Saqoosha/EPDEnvClock/docs/README.md

# EPDEnvClock Documentation

This directory contains various documentation for the EPDEnvClock project.

## 📚 Document List

### Feature Guides

- **[ImageBW Wi-Fi Export](./README_IMAGEBW.md)** - How to use the feature that sends ImageBW data to Mac via Wi-Fi
- **[SCD41 Sensor Integration](./README_SCD41.md)** - Connection and configuration guide for the SCD41 CO2/temperature/humidity sensor

### Analysis Reports

- **[Battery Discharge Report](./BATTERY_REPORT.md)** - 10-day battery discharge analysis with MAX17048 accuracy evaluation

### Code Reviews

- **[Sensor Management Code Review](./reviews/SENSOR_MANAGEMENT_REVIEW.md)** - Implementation status and improvement suggestions for SCD41 sensor management

## 📖 Project-Wide Documentation

The following documents are also available in the project root:

- **[AGENTS.md](../AGENTS.md)** - Arduino CLI compile/upload instructions
- **[README.md](../README.md)** - Project overview

## 🔍 Finding Documentation

- **Want to know how to use a feature** → Refer to Feature Guides
- **Want to check code issues** → Refer to Code Reviews
- **Want to know how to build/upload** → Refer to [AGENTS.md](../AGENTS.md)
