Saqoosha/EPDEnvClock/docs/README_ja.md

# EPDEnvClock ドキュメント

このディレクトリには、EPDEnvClockプロジェクトの各種ドキュメントが含まれています。

## 📚 ドキュメント一覧

### 機能ガイド

- **[ImageBW Wi-Fi Export](./README_IMAGEBW_ja.md)** - ImageBWデータをWi-Fi経由でMacに送信する機能の使い方
- **[SCD41 センサー統合](./README_SCD41_ja.md)** - SCD41 CO2/温度/湿度センサーの接続と設定ガイド

### 分析レポート

- **[バッテリー放電レポート](./BATTERY_REPORT.md)** - 10日間のバッテリー放電分析とMAX17048精度評価

### コードレビュー

- **[センサー管理コードレビュー](./reviews/SENSOR_MANAGEMENT_REVIEW_ja.md)** - SCD41センサー管理の実装状況と改善提案

## 📖 プロジェクト全体のドキュメント

プロジェクトルートには以下のドキュメントもあります：

- **[AGENTS.md](../AGENTS.md)** - Arduino CLIコンパイル・アップロード手順書
- **[README.md](../README.md)** - プロジェクト全体の概要

## 🔍 ドキュメントの探し方

- **機能の使い方を知りたい** → 機能ガイドを参照
- **コードの問題点を確認したい** → コードレビューを参照
- **ビルド・アップロード方法を知りたい** → [AGENTS.md](../AGENTS.md)を参照
