Saqoosha/EPDEnvClock/docs/README_SCD41_ja.md

# SCD41センサー統合ガイド

このドキュメントは、SCD41 CO2/温度/湿度センサーをCrowPanel ESP32-S3に接続する方法を説明します。

## ハードウェア接続

### 接続ピン

- **SCD41 VDD** → ESP32-S3 **3.3V**
- **SCD41 GND** → ESP32-S3 **GND**
- **SCD41 SDA** → ESP32-S3 **GPIO 38**
- **SCD41 SCL** → ESP32-S3 **GPIO 20**

**注意**: プルアップ抵抗はSCD41モジュールに内蔵されているため、追加のハードウェアは不要です。

## ライブラリのインストール

### Sensirion SCD4x Arduinoライブラリ

SCD41センサーを使用するには、Sensirion SCD4x Arduinoライブラリが必要です。

#### arduino-cliを使用する場合

```bash
arduino-cli lib install "Sensirion I2C SCD4x"
```

または、ライブラリのGitHubリポジトリから直接インストール：

```bash
arduino-cli lib install --git-url https://github.com/Sensirion/arduino-i2c-scd4x.git
```

#### Arduino IDEを使用する場合

1. Arduino IDEを開く
2. **スケッチ** → **ライブラリをインクルード** → **ライブラリを管理...**
3. 検索バーに「Sensirion I2C SCD4x」と入力
4. 「Sensirion I2C SCD4x」を選択してインストール

### ライブラリの確認

インストールされたライブラリを確認：

```bash
arduino-cli lib list | grep -i scd4x
```

## ソフトウェア設定

### I2Cピン設定

コード内で以下のようにI2Cピンを設定しています：

```cpp
#define I2C_SDA_PIN 38
#define I2C_SCL_PIN 20
```

### センサー読み取り間隔

デフォルトでは5秒ごとにセンサー値を読み取ります：

```cpp
#define SENSOR_READ_INTERVAL 5000  // ミリ秒
```

### 温度オフセット設定

SCD41センサーは自己発熱により、実際の環境温度より高い温度を測定する傾向があります。この問題を補正するため、センサー初期化時に温度オフセットを設定しています。

**公式ドキュメントによる説明**:

Sensirionの公式データシート（[SCD4x Datasheet](https://admin.sensirion.com/media/documents/48C4B7FB/64C134E7/Sensirion_SCD4x_Datasheet.pdf)）によると：

> 「SCD4x内の温度オフセットを正しく設定することで、RH（相対湿度）およびT（温度）の出力信号を活用できます。温度オフセットは、SCD4xの測定モード、近接する部品の自己発熱、周囲温度、気流など、さまざまな要因に依存する可能性があります。したがって、SCD4xの温度オフセットは、最終デバイスに統合し、通常の動作条件下（アプリケーションで使用する動作モードを含む）で熱平衡に達した後に決定する必要があります。」

**温度オフセットの定義と符号について**:

データシートによると、温度オフセットは以下のように定義されています：

- **温度オフセット = 測定された温度 - 実際の周囲温度**

つまり、センサーが実際の周囲温度より**高い温度を測定する場合**、オフセットは**正の値**になります。

**センサー内部のデフォルト値**:

- **センサーのEEPROMにデフォルトで4.0°Cが保存されています**（工場出荷時の設定）
- この値はセンサー内部に保存されており、電源を切っても保持されます
- 初期化時に現在のオフセット値を読み取り、表示します

**重要な動作**:

- `setTemperatureOffset()`は既存の値を**上書き（置き換え）**します
- **温度オフセットの適用方法**: `表示温度 = 実際の環境温度 - オフセット`
- **計算例**（ユーザーの理解通り）:
  - デフォルトの+4°Cオフセットでセンサーが28°Cを表示する場合：
    - 実際の環境温度 = 28 - 4 = 24°C
  - -3°Cのオフセットを設定すると：
    - 表示温度 = 24 - 3 = 21°C（オフセットが負の値の場合、実際の環境温度からさらに引く）
    - **結果**: 28°C → 21°C（**7°Cの減少**）
  - つまり、+4°Cから-3°Cに変更すると、表示温度は7°C下がります

**本プロジェクトでの設定**:

- 本プロジェクトでの設定: **4.0°C**（センサーのデフォルト値を使用）
- 初期化時にセンサー内部の現在のオフセット値を読み取り、その後値を設定します
- 設定後、再度読み取って正しく設定されたことを確認します

**注意**: データシートの「4°C」は、センサーが実際の周囲温度より4°C高い温度を測定する場合の補正値として定義されています。しかし、`setTemperatureOffset()`メソッドの実装によっては、符号が異なる場合があります。実際の動作を確認して、適切な値を設定してください。

**推奨オフセット範囲**:

- 公式推奨範囲: **0°Cから20°C**（正の値）
- 実際の使用環境に応じて調整が必要

このオフセットはセンサー内部に保存され、読み取った温度に適用されます（実装によって加算または減算されます）。

**オフセット値の調整**:

`EPDEnvClock/sensor_manager.cpp`の以下の定数を変更することで、オフセット値を調整できます：

```cpp
scd4x.setTemperatureOffset(4.0f);  // デフォルト: 4.0°C
```

**推奨調整方法**（公式ドキュメントに基づく）:

1. **最終デバイスに統合後**に調整を行う（センサー単体ではなく、実際の使用環境で）
2. **通常の動作条件下**で測定（アプリケーションで使用する動作モードを含む）
3. **熱平衡に達した後**に温度差を測定（センサー起動後、十分な時間が経過してから）
4. 正確な温度計と比較して、実際の温度差を測定
5. 測定した温度差に基づいてオフセット値を調整（公式推奨範囲: 0°Cから20°C）
6. センサーを再起動して、設定したオフセットが適用されているか確認

**注意**:

- オフセット設定はセンサー内部に保存されるため、一度設定すると電源を切っても保持されます
- 新しいオフセット値を設定する場合は、センサーを再起動する必要があります
- 温度オフセットは、**相対湿度（RH）の精度にも影響**するため、正確な設定が重要です

## 使用方法

### 通常動作

センサー値は現在時刻・日付とともに電子ペーパーディスプレイに自動的に表示されます。システムは以下のように動作します：

1. ディープスリープからの復帰時にセンサーを初期化
2. シングルショット測定を実行（約5秒）
3. CO2（ppm）、温度（°C）、湿度（%RH）をEPDに表示
4. 次の分までディープスリープに入る

### シリアルモニターでのデバッグ

シリアルモニターを115200bpsで開くと、センサーの初期化状態やエラーメッセージを確認できます。

## トラブルシューティング

### センサーが初期化できない場合

1. **接続を確認**:
   - SDAがGPIO 38に接続されているか
   - SCLがGPIO 20に接続されているか
   - VDDが3.3Vに接続されているか
   - GNDが接続されているか

2. **I2Cバスの確認**:
   - I2Cスキャナーを使用してセンサーが検出されるか確認
   - デフォルトI2Cアドレス: 0x62

3. **電源の確認**:
   - SCD41は2.4V-5.5Vで動作しますが、3.3V推奨
   - 電源が安定しているか確認

### データが読み取れない場合

1. **初期化時間**: センサーの初回起動時は約5秒の初期化時間が必要です
2. **読み取り間隔**: 定期的な読み取り間隔は5秒以上推奨（センサーの応答時間60秒を考慮）
3. **シリアル出力**: エラーメッセージを確認して問題を特定

### 温度が高めに表示される場合

SCD41センサーは自己発熱により、実際の環境温度より高い温度を測定する傾向があります。この問題を解決するため、以下の対策を実装しています：

1. **温度オフセット設定**: センサー初期化時に4.0°Cのオフセットを設定（センサーのデフォルト値）
2. **オフセット調整**: 正確な温度計と比較して、必要に応じてオフセット値を調整

**温度オフセットの確認**:

シリアル出力で以下のメッセージが表示されれば、オフセット設定は成功しています：

```text
Temperature offset set to 4.0°C successfully.
Read back temperature offset: 4.00 °C
```

**注意**:

- センサー内部にはデフォルトで4.0°CのオフセットがEEPROMに保存されています
- 本プロジェクトではこのデフォルト値をそのまま使用しています
- 温度オフセットは自己発熱を補正するためのものです

**オフセット設定が失敗した場合**:

警告メッセージが表示されますが、センサーの動作には影響しません。オフセット設定はオプション機能です。

## センサー仕様

- **I2Cアドレス**: 0x62 (デフォルト)
- **測定範囲**:
  - CO2: 400-5000ppm
  - 温度: -10～+60°C
  - 湿度: 0-100%RH
- **精度**:
  - CO2: ±(40ppm+5%)
  - 温度: ±0.8°C (15-35°Cの範囲)
  - 湿度: ±6%RH (15-35°C、20-65%RHの範囲)

## 参考リソース

### 公式ドキュメント

- **[Sensirion SCD4x Datasheet (公式データシート)](https://admin.sensirion.com/media/documents/48C4B7FB/64C134E7/Sensirion_SCD4x_Datasheet.pdf)**
  - 温度オフセット設定についての詳細な説明が記載されています
  - セクション: Temperature Offset Compensation

- **[Sensirion SCD4x Python API Documentation](https://sensirion.github.io/python-i2c-scd/api.html)**
  - 温度オフセット設定のAPIリファレンス

### コミュニティリソース

- [LaskaKit SCD41 GitHub](https://github.com/LaskaKit/SCD41-CO2-Sensor)
- [Sensirion SCD4x Arduinoライブラリ](https://github.com/Sensirion/arduino-i2c-scd4x)
