Saqoosha/EPDEnvClock/EPDEnvClock/sensor_logger.h

#pragma once

#include <Arduino.h>
#include <time.h>

// Initialize sensor logger (call once in setup)
void SensorLogger_Init();

// Log sensor values to JSONL file on SD card
// Returns true if successful, false otherwise
// rtcDriftMs: RTC drift in milliseconds from last NTP sync (residual after compensation)
// cumulativeCompensationMs: total drift compensation applied since last NTP sync
// driftRateMsPerMin: current drift rate used for compensation (ms/min)
// driftValid: true if drift values contain valid measurements
// batteryPercent: linear battery percent (3.4V=0%, 4.2V=100%) - used for display
// batteryMax17048Percent: MAX17048 reported percent - for reference/analysis
// batteryChargeRate: battery charge/discharge rate in %/hr (positive=charging, negative=discharging)
// batteryCharging: true if battery is currently charging (from 4054A CHRG pin)
bool SensorLogger_LogValues(
    const struct tm &timeinfo,
    time_t unixTimestamp,
    int32_t rtcDriftMs,
    int64_t cumulativeCompensationMs,
    float driftRateMsPerMin,
    bool driftValid,
    float temperature,
    float humidity,
    uint16_t co2,
    float batteryVoltage,
    float batteryPercent,
    float batteryMax17048Percent,
    float batteryChargeRate,
    bool batteryCharging);

// Delete log files older than specified days
// Returns number of files deleted
int SensorLogger_DeleteOldFiles(int maxAgeDays = 30);

// Get unsent sensor readings from log files
// lastUploadedTime: timestamp of the last successfully uploaded data point
// payload: String to append the JSON array of readings to
// latestTimestamp: Output parameter to store the timestamp of the last reading added
// maxReadings: maximum number of readings to retrieve (default 120 = 2 hours)
// Returns: number of readings added to payload
int SensorLogger_GetUnsentReadings(time_t lastUploadedTime, String &payload, time_t &latestTimestamp, int maxReadings = 120);
