Saqoosha/EPDEnvClock/EPDEnvClock/bitmaps/Number_M_bitmap.h

#ifndef NUMBER_M_BITMAP_H
#define NUMBER_M_BITMAP_H

#include <Arduino.h>

const uint8_t NumberM0[] = {
  0x00,0x00,0x1F,0xFC,0x00,0x00,0x00,0x00,0x01,0xFF,0xFF,0x80,0x00,0x00,0x00,0x07,
  0xFF,0xFF,0xE0,0x00,0x00,0x00,0x1F,0xFF,0xFF,0xF8,0x00,0x00,0x00,0x3F,0xFF,0xFF,
  0xFE,0x00,0x00,0x00,0x7F,0xFF,0xFF,0xFF,0x00,0x00,0x00,0xFF,0xFF,0xFF,0xFF,0x80,
  0x00,0x01,0xFF,0xFF,0xFF,0xFF,0xC0,0x00,0x03,0xFF,0xFF,0xFF,0xFF,0xE0,0x00,0x07,
  0xFF,0xFF,0xFF,0xFF,0xE0,0x00,0x0F,0xFF,0xFF,0xFF,0xFF,0xF0,0x00,0x0F,0xFF,0xFF,
  0xFF,0xFF,0xF8,0x00,0x1F,0xFF,0xFC,0x1F,0xFF,0xF8,0x00,0x1F,0xFF,0xF0,0x07,0xFF,
  0xFC,0x00,0x3F,0xFF,0xE0,0x03,0xFF,0xFC,0x00,0x3F,0xFF,0xC0,0x03,0xFF,0xFE,0x00,
  0x3F,0xFF,0xC0,0x01,0xFF,0xFE,0x00,0x7F,0xFF,0x80,0x01,0xFF,0xFE,0x00,0x7F,0xFF,
  0x80,0x00,0xFF,0xFF,0x00,0x7F,0xFF,0x80,0x00,0xFF,0xFF,0x00,0x7F,0xFF,0x00,0x00,
  0xFF,0xFF,0x00,0x7F,0xFF,0x00,0x00,0xFF,0xFF,0x00,0xFF,0xFF,0x00,0x00,0x7F,0xFF,
  0x00,0xFF,0xFF,0x00,0x00,0x7F,0xFF,0x00,0xFF,0xFF,0x00,0x00,0x7F,0xFF,0x00,0xFF,
  0xFF,0x00,0x00,0x7F,0xFF,0x80,0xFF,0xFF,0x00,0x00,0x7F,0xFF,0x80,0xFF,0xFF,0x00,
  0x00,0x7F,0xFF,0x80,0xFF,0xFF,0x00,0x00,0x7F,0xFF,0x80,0xFF,0xFF,0x00,0x00,0x7F,
  0xFF,0x80,0xFF,0xFF,0x00,0x00,0x7F,0xFF,0x80,0xFF,0xFF,0x00,0x00,0x7F,0xFF,0x80,
  0xFF,0xFF,0x00,0x00,0x7F,0xFF,0x00,0xFF,0xFF,0x00,0x00,0x7F,0xFF,0x00,0xFF,0xFF,
  0x00,0x00,0x7F,0xFF,0x00,0xFF,0xFF,0x00,0x00,0xFF,0xFF,0x00,0x7F,0xFF,0x00,0x00,
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
  0xFF,0xFF,0x80,0xFF,0xFF,0x80,0xFF,0xFF,0x80,0xFF,0xFF,0x80,0x7F,0xFF,0x00,0x7F,
  0xFF,0x00,0x3F,0xFE,0x00,0x3F,0xFE,0x00,0x0F,0xF8,0x00,0x07,0xF0,0x00
}; // 174 bytes
#define NumberMPeriod_WIDTH 17
#define NumberMPeriod_HEIGHT 58

#endif
