Saqoosha/EPDEnvClock/EPDEnvClock/bitmaps/Number_bitmap_S.h

#ifndef NUMBER_BITMAP_H
#define NUMBER_BITMAP_H

#include <Arduino.h>

const uint8_t Number0[] = {
  0x00,0x00,0x00,0x00,0x00,0x00,0x07,0xFC,0x00,0x00,0x00,0x3F,0xFF,0x80,0x00,0x00,
  0xFF,0xFF,0xE0,0x00,0x01,0xFF,0xFF,0xF0,0x00,0x03,0xFF,0xFF,0xF8,0x00,0x07,0xFF,
  0xFF,0xFC,0x00,0x0F,0xFF,0xFF,0xFE,0x00,0x1F,0xFF,0xFF,0xFF,0x00,0x1F,0xFF,0xFF,
  0xFF,0x00,0x3F,0xFE,0x0F,0xFF,0x80,0x3F,0xFC,0x07,0xFF,0x80,0x7F,0xF8,0x03,0xFF,
  0xC0,0x7F,0xF8,0x03,0xFF,0xC0,0x7F,0xF0,0x01,0xFF,0xC0,0x7F,0xF0,0x01,0xFF,0xC0,
  0xFF,0xF0,0x01,0xFF,0xE0,0xFF,0xF0,0x01,0xFF,0xE0,0xFF,0xE0,0x00,0xFF,0xE0,0xFF,
  0xE0,0x00,0xFF,0xE0,0xFF,0xE0,0x00,0xFF,0xE0,0xFF,0xE0,0x00,0xFF,0xE0,0xFF,0xE0,
  0x00,0xFF,0xE0,0xFF,0xE0,0x00,0xFF,0xE0,0xFF,0xE0,0x00,0xFF,0xE0,0xFF,0xE0,0x00,
  0xFF,0xE0,0xFF,0xF0,0x01,0xFF,0xE0,0xFF,0xF0,0x01,0xFF,0xE0,0x7F,0xF0,0x01,0xFF,
  0xC0,0x7F,0xF0,0x01,0xFF,0xC0,0x7F,0xF8,0x03,0xFF,0xC0,0x7F,0xF8,0x03,0xFF,0xC0,
  0x3F,0xFC,0x07,0xFF,0x80,0x3F,0xFE,0x0F,0xFF,0x80,0x1F,0xFF,0xFF,0xFF,0x00,0x1F,
  0xFF,0xFF,0xFF,0x00,0x0F,0xFF,0xFF,0xFE,0x00,0x07,0xFF,0xFF,0xFC,0x00,0x03,0xFF,
  0xFF,0xF8,0x00,0x01,0xFF,0xFF,0xF0,0x00,0x00,0xFF,0xFF,0xE0,0x00,0x00,0x3F,0xFF,
  0x80,0x00,0x00,0x07,0xFC,0x00,0x00
}; // 215 bytes
#define Number0_WIDTH 35
#define Number0_HEIGHT 43

const uint8_t Number1[] = {
  0x00,0x00,0x00,0x00,0x3F,0x80,0x01,0xFF,0xC0,0x0F,0xFF,0xE0,0x3F,0xFF,0xF0,0x7F,
  0xFF,0xF0,0xFF,0xFF,0xF0,0xFF,0xFF,0xF0,0xFF,0xFF,0xF0,0xFF,0xFF,0xF0,0xFF,0xFF,
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
  0x00,0x00,0x00,0x00,0x00,0x00,0x00,0x00,0x00,0x00,0x00,0x00,0x0F,0x80,0x3F,0xE0,
  0x7F,0xF0,0x7F,0xF0,0xFF,0xF8,0xFF,0xF8,0xFF,0xF8,0xFF,0xF8,0xFF,0xF8,0x7F,0xF0,
  0x7F,0xF0,0x3F,0xE0,0x0F,0x80
}; // 86 bytes
#define NumberPeriod_WIDTH 13
#define NumberPeriod_HEIGHT 43

#endif
