Saqoosha/EPDEnvClock/EPDEnvClock/EPDfont_12px_spleen.h

// 12x12 pixel font: ascii_1206_spleen
// Spleen 6x12 monospaced bitmap font
// 95 characters: space (' ') to tilde ('~')
// 12 bytes per character
const unsigned char ascii_1206_spleen[95][12]={
{0x00,0x00,0x00,0x00,0x00,0x00,0x00,0x00,0x00,0x00,0x00,0x00},/*" ",0*/
{0x00,0x00,0x7E,0x00,0x00,0x00,0x00,0x00,0x01,0x00,0x00,0x00},/*"!",1*/
{0x00,0x0E,0x00,0x0E,0x00,0x00,0x00,0x00,0x00,0x00,0x00,0x00},/*""",2*/
{0x88,0xFC,0x88,0xFC,0x88,0x00,0x00,0x01,0x00,0x01,0x00,0x00},/*"#",3*/
{0x0C,0x12,0xFF,0x12,0xE2,0x00,0x01,0x01,0x03,0x01,0x00,0x00},/*"$",4*/
{0x00,0x8C,0x60,0x18,0xC6,0x00,0x00,0x01,0x00,0x00,0x00,0x00},/*"%",5*/
{0xC0,0x2C,0x32,0x52,0x8C,0x40,0x00,0x01,0x01,0x01,0x00,0x01},/*"&",6*/
{0x00,0x00,0x0E,0x00,0x00,0x00,0x00,0x00,0x00,0x00,0x00,0x00},/*"'",7*/
{0x00,0xFC,0x02,0x01,0x01,0x00,0x00,0x00,0x01,0x02,0x02,0x00},/*"(",8*/
{0x00,0x01,0x01,0x02,0xFC,0x00,0x00,0x02,0x02,0x01,0x00,0x00},/*")",9*/
{0x20,0xA8,0x70,0x70,0xA8,0x20,0x00,0x00,0x00,0x00,0x00,0x00},/*"*",10*/
{0x20,0x20,0xF8,0x20,0x20,0x00,0x00,0x00,0x00,0x00,0x00,0x00},/*"+",11*/
{0x00,0x00,0x80,0x00,0x00,0x00,0x00,0x02,0x01,0x00,0x00,0x00},/*",",12*/
{0x20,0x20,0x20,0x20,0x20,0x00,0x00,0x00,0x00,0x00,0x00,0x00},/*"-",13*/
{0x00,0x00,0x00,0x00,0x00,0x00,0x00,0x00,0x01,0x00,0x00,0x00},/*".",14*/
{0x00,0xC0,0x30,0x0C,0x03,0x00,0x03,0x00,0x00,0x00,0x00,0x00},/*"/",15*/
{0xFC,0x22,0x12,0x0A,0xFC,0x00,0x00,0x01,0x01,0x01,0x00,0x00},/*"0",16*/
{0x00,0x04,0xFE,0x00,0x00,0x00,0x00,0x01,0x01,0x01,0x00,0x00},/*"1",17*/
{0xC4,0x22,0x22,0x22,0x1C,0x00,0x01,0x01,0x01,0x01,0x01,0x00},/*"2",18*/
{0x84,0x02,0x12,0x12,0xEC,0x00,0x00,0x01,0x01,0x01,0x00,0x00},/*"3",19*/
{0x7E,0x40,0x40,0xF8,0x40,0x00,0x00,0x00,0x00,0x01,0x00,0x00},/*"4",20*/
{0x1E,0x12,0x12,0x12,0xE2,0x00,0x01,0x01,0x01,0x01,0x00,0x00},/*"5",21*/
{0xFC,0x12,0x12,0x12,0xE0,0x00,0x00,0x01,0x01,0x01,0x00,0x00},/*"6",22*/
{0x06,0x02,0xE2,0x12,0x0E,0x00,0x00,0x00,0x01,0x00,0x00,0x00},/*"7",23*/
{0xEC,0x12,0x12,0x12,0xEC,0x00,0x00,0x01,0x01,0x01,0x00,0x00},/*"8",24*/
{0x1C,0x22,0x22,0x22,0xFC,0x00,0x00,0x01,0x01,0x01,0x00,0x00},/*"9",25*/
{0x00,0x00,0x10,0x00,0x00,0x00,0x00,0x00,0x01,0x00,0x00,0x00},/*":",26*/
{0x00,0x00,0x90,0x00,0x00,0x00,0x00,0x02,0x01,0x00,0x00,0x00},/*";",27*/
{0x00,0x30,0x48,0x84,0x02,0x00,0x00,0x00,0x00,0x00,0x01,0x00},/*"<",28*/
{0x50,0x50,0x50,0x50,0x50,0x00,0x00,0x00,0x00,0x00,0x00,0x00},/*"=",29*/
{0x00,0x02,0x84,0x48,0x30,0x00,0x00,0x01,0x00,0x00,0x00,0x00},/*">",30*/
{0x04,0x02,0x62,0x12,0x0C,0x00,0x00,0x00,0x01,0x00,0x00,0x00},/*"?",31*/
{0xFC,0x02,0x72,0x72,0x7C,0x00,0x00,0x01,0x01,0x01,0x01,0x00},/*"@",32*/
{0xFC,0x22,0x22,0x22,0xFC,0x00,0x01,0x00,0x00,0x00,0x01,0x00},/*"A",33*/
{0xFE,0x12,0x12,0x12,0xEC,0x00,0x01,0x01,0x01,0x01,0x00,0x00},/*"B",34*/
{0xFC,0x02,0x02,0x02,0x02,0x00,0x00,0x01,0x01,0x01,0x01,0x00},/*"C",35*/
{0xFE,0x02,0x02,0x02,0xFC,0x00,0x01,0x01,0x01,0x01,0x00,0x00},/*"D",36*/
{0xFC,0x12,0x12,0x12,0x02,0x00,0x00,0x01,0x01,0x01,0x01,0x00},/*"E",37*/
{0xFC,0x12,0x12,0x12,0x02,0x00,0x01,0x00,0x00,0x00,0x00,0x00},/*"F",38*/
{0xFC,0x02,0x12,0x12,0xF2,0x00,0x00,0x01,0x01,0x01,0x01,0x00},/*"G",39*/
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
};
