Saqoosha/EPDEnvClock/EPDEnvClock/bitmaps/Icon_co2_bitmap.h

#ifndef ICON_CO2_BITMAP_H
#define ICON_CO2_BITMAP_H

#include <Arduino.h>

const uint8_t IconCO2[] = {
  0x00,0x00,0x00,0x00,0x00,0x00,0x00,0x00,0x00,0x00,0x00,0x00,0x00,0x00,0x00,0x00,
  0x00,0x00,0x00,0x00,0x00,0x00,0x00,0x00,0x00,0x00,0x00,0x00,0x00,0x00,0x00,0x00,
  0x00,0x00,0x00,0x00,0x00,0x00,0x00,0x00,0x00,0x00,0x00,0x00,0x00,0x00,0x00,0x00,
  0x00,0x00,0x00,0x00,0x00,0x00,0x00,0x00,0x00,0x00,0x00,0x00,0x00,0x00,0x00,0x00,
  0x00,0x00,0x00,0x00,0x00,0x00,0x00,0x00,0x00,0x00,0x00,0x00,0x00,0x00,0x00,0x00,
  0x00,0x00,0x03,0xF0,0x00,0x00,0x00,0x00,0x00,0x00,0x0F,0xFC,0x00,0x00,0x00,0x00,
  0x00,0x00,0x3F,0xFF,0x00,0x00,0x00,0x00,0x00,0x00,0xFC,0x0F,0xC0,0x00,0x00,0x00,
  0x00,0x01,0xF0,0x03,0xE0,0x00,0x00,0x00,0x00,0x03,0xC0,0x00,0xE0,0x00,0x00,0x00,
  0x00,0x07,0x80,0x00,0x77,0xC0,0x00,0x00,0x00,0x07,0x00,0x00,0x7F,0xF0,0x00,0x00,
  0x00,0x0F,0x00,0x00,0x3F,0xF8,0x00,0x00,0x00,0x0E,0x00,0x00,0x18,0x3C,0x00,0x00,
  0x00,0x0E,0x00,0x00,0x00,0x1E,0x00,0x00,0x00,0x1C,0x00,0x00,0x00,0x0E,0x00,0x00,
  0x00,0x1C,0x00,0x00,0x00,0x07,0x00,0x00,0x00,0x1C,0x00,0x00,0x00,0x07,0x00,0x00,
  0x00,0x1C,0x00,0x00,0x00,0x07,0x00,0x00,0x00,0x7C,0x00,0x00,0x00,0x07,0x00,0x00,
  0x00,0xF8,0x00,0x00,0x00,0x07,0x00,0x00,0x01,0xE0,0x1C,0x03,0x80,0x07,0x80,0x00,
  0x01,0xC0,0x7F,0x0F,0xE0,0x07,0xE0,0x00,0x03,0x80,0x7F,0x8F,0xE0,0x01,0xF0,0x00,
  0x03,0x80,0xE3,0x9C,0x70,0x00,0x70,0x00,0x07,0x00,0xE3,0x9C,0x70,0x00,0x38,0x00,
  0x07,0x00,0xE0,0x1C,0x71,0xE0,0x38,0x00,0x07,0x00,0xE0,0x1C,0x73,0xF0,0x1C,0x00,
  0x07,0x00,0xE0,0x1C,0x73,0x30,0x1C,0x00,0x07,0x00,0xE0,0x1C,0x70,0x70,0x1C,0x00,
  0x07,0x00,0xE3,0x9C,0x70,0xE0,0x1C,0x00,0x07,0x00,0xE3,0x9C,0x71,0xC0,0x1C,0x00,
  0x03,0x80,0x7F,0x8F,0xE3,0x80,0x1C,0x00,0x03,0x80,0x7F,0x0F,0xE3,0xF0,0x38,0x00,
  0x01,0xC0,0x1C,0x03,0x81,0xF0,0x38,0x00,0x01,0xE0,0x00,0x00,0x00,0x00,0x70,0x00,
  0x00,0xF0,0x00,0x00,0x00,0x00,0xF0,0x00,0x00,0x7E,0x00,0x00,0x00,0x07,0xE0,0x00,
  0x00,0x3F,0xFF,0xFF,0xFF,0xFF,0xC0,0x00,0x00,0x0F,0xFF,0xFF,0xFF,0xFF,0x00,0x00,
  0x00,0x01,0xFF,0xFF,0xFF,0xFC,0x00,0x00,0x00,0x00,0x00,0x00,0x00,0x00,0x00,0x00,
  0x00,0x00,0x00,0x00,0x00,0x00,0x00,0x00,0x00,0x00,0x00,0x00,0x00,0x00,0x00,0x00,
  0x00,0x00,0x00,0x00,0x00,0x00,0x00,0x00,0x00,0x00,0x00,0x00,0x00,0x00,0x00,0x00,
  0x00,0x00,0x00,0x00,0x00,0x00,0x00,0x00,0x00,0x00,0x00,0x00,0x00,0x00,0x00,0x00,
  0x00,0x00,0x00,0x00,0x00,0x00,0x00,0x00,0x00,0x00,0x00,0x00,0x00,0x00,0x00,0x00,
  0x00,0x00,0x00,0x00,0x00,0x00,0x00,0x00,0x00,0x00,0x00,0x00,0x00,0x00,0x00,0x00
}; // 464 bytes
#define IconCO2_WIDTH 58
#define IconCO2_HEIGHT 58

#endif
