Saqoosha/EPDEnvClock/EPDEnvClock/bitmaps/Icon_humidity_bitmap.h

#ifndef ICON_HUMIDITY_BITMAP_H
#define ICON_HUMIDITY_BITMAP_H

#include <Arduino.h>

const uint8_t IconHumidity[] = {
  0x00,0x00,0x00,0x00,0x00,0x00,0x00,0x00,0x00,0x00,0x00,0x00,0x00,0x00,0x00,0x00,
  0x00,0x00,0x00,0x00,0x00,0x00,0x00,0x00,0x00,0x00,0x00,0x00,0x00,0x00,0x00,0x00,
  0x00,0x00,0x00,0x1E,0x00,0x00,0x00,0x00,0x00,0x00,0x00,0x7F,0x00,0x00,0x00,0x00,
  0x00,0x00,0x00,0xFF,0xC0,0x00,0x00,0x00,0x00,0x00,0x01,0xFF,0xE0,0x00,0x00,0x00,
  0x00,0x00,0x03,0xF1,0xF0,0x00,0x00,0x00,0x00,0x00,0x07,0xC0,0xF8,0x00,0x00,0x00,
  0x00,0x00,0x0F,0x80,0x7C,0x00,0x00,0x00,0x00,0x00,0x1F,0x00,0x3E,0x00,0x00,0x00,
  0x00,0x00,0x3E,0x00,0x1F,0x00,0x00,0x00,0x00,0x00,0x7C,0x00,0x0F,0x80,0x00,0x00,
  0x00,0x00,0xF8,0x00,0x07,0xC0,0x00,0x00,0x00,0x01,0xF0,0x00,0x03,0xE0,0x00,0x00,
  0x00,0x03,0xE0,0x00,0x01,0xF0,0x00,0x00,0x00,0x07,0xC0,0x00,0x00,0xF8,0x00,0x00,
  0x00,0x07,0xC0,0x00,0x00,0xF8,0x00,0x00,0x00,0x0F,0x80,0x00,0x00,0x7C,0x00,0x00,
  0x00,0x0F,0x00,0x00,0x00,0x3C,0x00,0x00,0x00,0x1F,0x00,0x00,0x00,0x3E,0x00,0x00,
  0x00,0x1E,0x00,0x00,0x00,0x1E,0x00,0x00,0x00,0x3E,0x00,0x00,0x00,0x1F,0x00,0x00,
  0x00,0x3C,0x00,0x00,0x00,0x0F,0x00,0x00,0x00,0x3F,0xF0,0x00,0x00,0x0F,0x00,0x00,
  0x00,0x3F,0xFF,0x00,0x00,0x0F,0x00,0x00,0x00,0x7F,0xFF,0xE0,0x00,0x0F,0x80,0x00,
  0x00,0x7F,0xFF,0xF8,0x00,0x07,0x80,0x00,0x00,0x7F,0xFF,0xFE,0x00,0x0F,0x80,0x00,
  0x00,0x7F,0xFF,0xFF,0x80,0x3F,0x80,0x00,0x00,0x7F,0xFF,0xFF,0xFF,0xFF,0x80,0x00,
  0x00,0x7F,0xFF,0xFF,0xFF,0xFF,0x80,0x00,0x00,0x3F,0xFF,0xFF,0xFF,0xFF,0x00,0x00,
  0x00,0x3F,0xFF,0xFF,0xFF,0xFF,0x00,0x00,0x00,0x3F,0xFF,0xFF,0xFF,0xFF,0x00,0x00,
  0x00,0x3F,0xFF,0xFF,0xFF,0xFF,0x00,0x00,0x00,0x1F,0xFF,0xFF,0xFF,0xFE,0x00,0x00,
  0x00,0x1F,0xFF,0xFF,0xFF,0xFE,0x00,0x00,0x00,0x0F,0xFF,0xFF,0xFF,0xFC,0x00,0x00,
  0x00,0x0F,0xFF,0xFF,0xFF,0xFC,0x00,0x00,0x00,0x07,0xFF,0xFF,0xFF,0xF8,0x00,0x00,
  0x00,0x03,0xFF,0xFF,0xFF,0xF0,0x00,0x00,0x00,0x01,0xFF,0xFF,0xFF,0xE0,0x00,0x00,
  0x00,0x00,0xFF,0xFF,0xFF,0xC0,0x00,0x00,0x00,0x00,0x7F,0xFF,0xFF,0x80,0x00,0x00,
  0x00,0x00,0x3F,0xFF,0xFF,0x00,0x00,0x00,0x00,0x00,0x0F,0xFF,0xFC,0x00,0x00,0x00,
  0x00,0x00,0x03,0xFF,0xF0,0x00,0x00,0x00,0x00,0x00,0x00,0x3F,0x00,0x00,0x00,0x00,
  0x00,0x00,0x00,0x00,0x00,0x00,0x00,0x00,0x00,0x00,0x00,0x00,0x00,0x00,0x00,0x00,
  0x00,0x00,0x00,0x00,0x00,0x00,0x00,0x00,0x00,0x00,0x00,0x00,0x00,0x00,0x00,0x00,
  0x00,0x00,0x00,0x00,0x00,0x00,0x00,0x00,0x00,0x00,0x00,0x00,0x00,0x00,0x00,0x00,
  0x00,0x00,0x00,0x00,0x00,0x00,0x00,0x00,0x00,0x00,0x00,0x00,0x00,0x00,0x00,0x00
}; // 464 bytes
#define IconHumidity_WIDTH 58
#define IconHumidity_HEIGHT 58

#endif
