Saqoosha/EPDEnvClock/EPDEnvClock/bitmaps/Icon_temp_bitmap.h

#ifndef ICON_TEMP_BITMAP_H
#define ICON_TEMP_BITMAP_H

#include <Arduino.h>

const uint8_t IconTemp[] = {
  0x00,0x00,0x00,0x3F,0x00,0x00,0x00,0x00,0x00,0x00,0x00,0xFF,0xC0,0x00,0x00,0x00,
  0x00,0x00,0x01,0xFF,0xE0,0x00,0x00,0x00,0x00,0x00,0x03,0xFF,0xF0,0x00,0x00,0x00,
  0x00,0x00,0x07,0xC0,0xF8,0x00,0x00,0x00,0x00,0x00,0x0F,0x80,0x7C,0x00,0x00,0x00,
  0x00,0x00,0x0F,0x00,0x3C,0x00,0x00,0x00,0x00,0x00,0x0F,0x00,0x3C,0x00,0x00,0x00,
  0x00,0x00,0x1E,0x00,0x1E,0x00,0x00,0x00,0x00,0x00,0x1E,0x00,0x1E,0x00,0x00,0x00,
  0x00,0x00,0x1E,0x00,0x1E,0x00,0x00,0x00,0x00,0x00,0x1E,0x00,0x1E,0x00,0x00,0x00,
  0x00,0x00,0x1F,0xF0,0x1E,0x00,0x00,0x00,0x00,0x00,0x1F,0xF0,0x1E,0x00,0x00,0x00,
  0x00,0x00,0x1F,0xF0,0x1E,0x00,0x00,0x00,0x00,0x00,0x1E,0x00,0x1E,0x00,0x00,0x00,
  0x00,0x00,0x1E,0x00,0x1E,0x00,0x00,0x00,0x00,0x00,0x1F,0xF0,0x1E,0x00,0x00,0x00,
  0x00,0x00,0x1F,0xF0,0x1E,0x00,0x00,0x00,0x00,0x00,0x1F,0xF0,0x1E,0x00,0x00,0x00,
  0x00,0x00,0x1E,0x00,0x1E,0x00,0x00,0x00,0x00,0x00,0x1E,0x00,0x1E,0x00,0x00,0x00,
  0x00,0x00,0x1E,0x00,0x1E,0x00,0x00,0x00,0x00,0x00,0x1E,0x3F,0x1E,0x00,0x00,0x00,
  0x00,0x00,0x1E,0x3F,0x1E,0x00,0x00,0x00,0x00,0x00,0x1E,0x3F,0x1E,0x00,0x00,0x00,
  0x00,0x00,0x1E,0x3F,0x1E,0x00,0x00,0x00,0x00,0x00,0x1E,0x3F,0x1E,0x00,0x00,0x00,
  0x00,0x00,0x1E,0x3F,0x1E,0x00,0x00,0x00,0x00,0x00,0x1E,0x3F,0x1E,0x00,0x00,0x00,
  0x00,0x00,0x1E,0x3F,0x1E,0x00,0x00,0x00,0x00,0x00,0x1E,0x3F,0x1E,0x00,0x00,0x00,
  0x00,0x00,0x1E,0x3F,0x1E,0x00,0x00,0x00,0x00,0x00,0x1E,0x3F,0x1E,0x00,0x00,0x00,
  0x00,0x00,0x3E,0x3F,0x1F,0x00,0x00,0x00,0x00,0x00,0x3E,0x3F,0x1F,0x00,0x00,0x00,
  0x00,0x00,0x7C,0x3F,0x0F,0x80,0x00,0x00,0x00,0x00,0x78,0x7F,0x87,0x80,0x00,0x00,
  0x00,0x00,0xF0,0xFF,0xC3,0xC0,0x00,0x00,0x00,0x00,0xF0,0xFF,0xC3,0xC0,0x00,0x00,
  0x00,0x00,0xE1,0xFF,0xE1,0xC0,0x00,0x00,0x00,0x00,0xE1,0xFF,0xE1,0xC0,0x00,0x00,
  0x00,0x00,0xE1,0xFF,0xE1,0xC0,0x00,0x00,0x00,0x00,0xE1,0xFF,0xE1,0xC0,0x00,0x00,
  0x00,0x00,0xE1,0xFF,0xE1,0xC0,0x00,0x00,0x00,0x00,0xF0,0xFF,0xC3,0xC0,0x00,0x00,
  0x00,0x00,0xF0,0xFF,0xC3,0xC0,0x00,0x00,0x00,0x00,0x78,0x7F,0x87,0x80,0x00,0x00,
  0x00,0x00,0x78,0x1E,0x07,0x80,0x00,0x00,0x00,0x00,0x3C,0x00,0x0F,0x00,0x00,0x00,
  0x00,0x00,0x3F,0x00,0x3F,0x00,0x00,0x00,0x00,0x00,0x1F,0xC0,0xFE,0x00,0x00,0x00,
  0x00,0x00,0x0F,0xFF,0xFC,0x00,0x00,0x00,0x00,0x00,0x03,0xFF,0xF0,0x00,0x00,0x00,
  0x00,0x00,0x00,0xFF,0xC0,0x00,0x00,0x00,0x00,0x00,0x00,0x3F,0x00,0x00,0x00,0x00,
  0x00,0x00,0x00,0x00,0x00,0x00,0x00,0x00,0x00,0x00,0x00,0x00,0x00,0x00,0x00,0x00
}; // 464 bytes
#define IconTemp_WIDTH 58
#define IconTemp_HEIGHT 58

#endif
