Saqoosha/EPDEnvClock/EPDEnvClock/bitmaps/Unit_c_bitmap.h

#ifndef UNIT_C_BITMAP_H
#define UNIT_C_BITMAP_H

#include <Arduino.h>

const uint8_t UnitC[] = {
  0x07,0xC0,0x00,0x3F,0xC0,0x3F,0xF8,0x01,0xFF,0xF8,0x7F,0xFC,0x07,0xFF,0xFC,0x7F,
  0xFC,0x0F,0xFF,0xFE,0xFE,0xFE,0x1F,0xFF,0xFE,0xFC,0x7E,0x3F,0xFF,0xFE,0xF8,0x3E,
  0x7F,0xFE,0xFE,0xF8,0x3E,0x7F,0xE0,0x1C,0xFC,0x7E,0xFF,0xC0,0x00,0xFE,0xFE,0xFF,
  0x80,0x00,0x7F,0xFC,0xFF,0x00,0x00,0x7F,0xFC,0xFF,0x00,0x00,0x1F,0xF9,0xFF,0x00,
  0x00,0x0F,0xC1,0xFF,0x00,0x00,0x00,0x01,0xFF,0x00,0x00,0x00,0x01,0xFE,0x00,0x00,
  0x00,0x01,0xFF,0x00,0x00,0x00,0x01,0xFF,0x00,0x00,0x00,0x01,0xFF,0x00,0x00,0x00,
  0x00,0xFF,0x00,0x00,0x00,0x00,0xFF,0x80,0x00,0x00,0x00,0xFF,0xC0,0x00,0x00,0x00,
  0x7F,0xE0,0x04,0x00,0x00,0x7F,0xF0,0x1E,0x00,0x00,0x3F,0xFF,0xFE,0x00,0x00,0x3F,
  0xFF,0xFE,0x00,0x00,0x1F,0xFF,0xFE,0x00,0x00,0x07,0xFF,0xFE,0x00,0x00,0x03,0xFF,
  0xFC,0x00,0x00,0x00,0x7F,0xF0
}; // 150 bytes
#define UnitC_WIDTH 39
#define UnitC_HEIGHT 30

#endif
