Saqoosha/EPDEnvClock/EPDEnvClock/bitmaps/Unit_percent_bitmap.h

#ifndef UNIT_PERCENT_BITMAP_H
#define UNIT_PERCENT_BITMAP_H

#include <Arduino.h>

const uint8_t UnitPercent[] = {
  0x0F,0xF0,0x00,0xF0,0x00,0x3F,0xF8,0x01,0xF8,0x00,0x3F,0xFC,0x01,0xF8,0x00,0x7F,
  0xFE,0x03,0xF0,0x00,0x7E,0x7E,0x07,0xF0,0x00,0xFC,0x7E,0x0F,0xE0,0x00,0xFC,0x3E,
  0x0F,0xC0,0x00,0xFC,0x3E,0x1F,0xC0,0x00,0xFC,0x7E,0x3F,0x80,0x00,0x7E,0x7E,0x3F,
  0x00,0x00,0x7F,0xFC,0x7F,0x00,0x00,0x3F,0xFC,0xFE,0x00,0x00,0x3F,0xF8,0xFC,0x00,
  0x00,0x0F,0xF1,0xFC,0x00,0x00,0x00,0x03,0xF8,0x38,0x00,0x00,0x03,0xF0,0xFF,0x00,
  0x00,0x07,0xF3,0xFF,0x80,0x00,0x0F,0xE7,0xFF,0xC0,0x00,0x0F,0xC7,0xFF,0xE0,0x00,
  0x1F,0x87,0xE7,0xE0,0x00,0x3F,0x8F,0xC3,0xE0,0x00,0x7F,0x0F,0xC3,0xE0,0x00,0x7E,
  0x0F,0xC3,0xE0,0x00,0xFE,0x07,0xC7,0xE0,0x01,0xFC,0x07,0xFF,0xE0,0x01,0xF8,0x07,
  0xFF,0xC0,0x01,0xF8,0x03,0xFF,0xC0,0x01,0xF0,0x01,0xFF,0x80,0x00,0x60,0x00,0xFE,
  0x00,0x00,0x00,0x00,0x00,0x00
}; // 150 bytes
#define UnitPercent_WIDTH 35
#define UnitPercent_HEIGHT 30

#endif
