Saqoosha/EPDEnvClock/EPDEnvClock/bitmaps/Unit_ppm_bitmap.h

#ifndef UNIT_PPM_BITMAP_H
#define UNIT_PPM_BITMAP_H

#include <Arduino.h>

const uint8_t UnitPpm[] = {
  0x00,0x00,0x00,0x00,0x00,0x00,0x00,0x00,0x00,0x00,0x00,0x00,0x00,0x00,0x00,0x00,
  0x00,0x00,0x00,0x00,0x00,0x00,0x00,0x00,0x00,0x00,0x00,0x00,0x00,0x00,0x00,0x00,
  0x00,0x00,0x00,0x00,0x00,0x00,0x00,0x00,0x00,0x00,0x00,0x00,0x00,0x00,0x00,0x00,
  0x00,0x00,0x00,0x00,0x00,0x00,0x00,0x00,0x00,0x00,0x00,0x00,0x00,0x00,0x00,0x00,
  0x00,0x00,0x00,0x00,0x00,0x00,0x00,0x00,0x00,0x00,0x00,0x00,0x00,0x00,0x00,0x00,
  0x00,0x00,0x00,0x00,0x00,0x00,0x00,0x00,0x00,0x00,0x00,0x00,0x00,0x00,0x00,0x00,
  0x00,0x00,0x00,0x00,0x00,0x00,0x00,0x00,0x07,0x80,0x00,0xF0,0x00,0x1E,0x07,0x80,
  0x3F,0xF8,0x07,0xFF,0x00,0xFF,0xFF,0xE0,0x7F,0xFC,0x0F,0xFF,0x81,0xFF,0xFF,0xF0,
  0x7F,0xFE,0x1F,0xFF,0xC3,0xFF,0xFF,0xF8,0x7C,0x7F,0x1F,0x8F,0xC3,0xF3,0xF9,0xF8,
  0x7C,0x3F,0x1F,0x07,0xE3,0xE1,0xF0,0xF8,0x7C,0x1F,0x1F,0x07,0xE3,0xE1,0xF0,0xF8,
  0x7C,0x1F,0x1F,0x03,0xE3,0xE1,0xF0,0xFC,0x7C,0x1F,0x1F,0x03,0xE3,0xE1,0xF8,0xFC,
  0x7C,0x1F,0x1F,0x03,0xE3,0xE1,0xF0,0xF8,0x7C,0x1F,0x1F,0x07,0xE3,0xE1,0xF0,0xF8,
  0x7C,0x3F,0x1F,0x87,0xC3,0xE1,0xF0,0xF8,0x7F,0xFE,0x1F,0xFF,0xC3,0xE1,0xF0,0xF8,
  0xFF,0xFE,0x1F,0xFF,0x83,0xE1,0xF0,0xF8,0xFF,0xFC,0x1F,0xFF,0x83,0xE1,0xF0,0x78,
  0x7F,0xF0,0x1F,0xFE,0x01,0xE0,0xF0,0x78,0x7C,0x00,0x1F,0x00,0x00,0x00,0x00,0x00,
  0x7C,0x00,0x1F,0x00,0x00,0x00,0x00,0x00,0x7C,0x00,0x1F,0x00,0x00,0x00,0x00,0x00,
  0x7C,0x00,0x1F,0x00,0x00,0x00,0x00,0x00,0x7C,0x00,0x0F,0x00,0x00,0x00,0x00,0x00,
  0x3C,0x00,0x0F,0x00,0x00,0x00,0x00,0x00
}; // 280 bytes
#define UnitPpm_WIDTH 62
#define UnitPpm_HEIGHT 35

#endif
