Saqoosha/EPDEnvClock/EPDEnvClock/bitmaps/Icon_bitmap.h

#ifndef ICON_BITMAP_H
#define ICON_BITMAP_H

#include <Arduino.h>

// Include individual icon bitmap headers
#include "Icon_temp_bitmap.h"
#include "Icon_humidity_bitmap.h"
#include "Icon_co2_bitmap.h"

// Include unit icon bitmap headers
#include "Unit_c_bitmap.h"
#include "Unit_percent_bitmap.h"
#include "Unit_ppm_bitmap.h"

#endif
