Saqoosha/EPDEnvClock/(commit log)

2025-11-15 Initial commit: ESP32-S3 EPD display project with arduino-cli setup
2025-11-15 Update documentation and fix image conversion
    - Update AGENTS.md with accurate arduino-cli behavior documentation
    - Fix image conversion: remove unnecessary inversion for EPD_ShowPicture
    - Update to use 792x272 resolution (actual display area)
    - Add detailed explanation of EPD display resolution and controller setup
    - Document compile --upload as recommended method
    [Document_bitmap.h, convert_image.py]
2025-11-15 Add Wi-Fi and NTP time sync with status display
    - Add Wi-Fi connection with ntp.nict.jp NTP server
    - Display current time in HH:MM format using bitmap numbers
    - Update display every minute automatically
    - Show setup progress status on display (EPD init, WiFi, NTP)
    - Show runtime status at bottom (WiFi status, NTP status, timing info, uptime)
    - Measure and display processing times for WiFi, NTP, and display updates
    - Add wifi_config.h.example template (wifi_config.h is gitignored)
    - Add .gitignore to prevent committing WiFi credentials
    [EPDClock.ino]
2025-11-15 Add WiFi ImageBW export feature
    - Add Python HTTP server (imagebw_server.py) to receive ImageBW data from Arduino
    - Add ImageBW to PNG converter (convert_imagebw.py) with proper rotation and gap handling
    - Add server configuration header (server_config.h)
    - Add HTTP client functionality to EPDClock.ino to send ImageBW to server
    - Handle 180-degree rotation and 8px center gap (396-403) in conversion
    - Output images as 792x272 PNG files matching actual display size
2025-11-15 Reorganize project structure: separate firmware, scripts, and docs
    - Move Arduino code to EPDClock/ directory (sketch directory)
    - Move Python scripts to scripts/ directory
    - Move documentation to docs/ directory
    - Organize EPD library files in EPDClock/ directory
    - Update AGENTS.md with new directory structure
    - Rename firmware.ino to EPDClock.ino to match directory name
2025-11-15 Add ImageBW server start/stop instructions to AGENTS.md
    - Add server startup instructions with options
    - Add server stop methods (pkill and kill by PID)
    - Add server status check command
    - Add endpoint documentation
    - Add configuration and output information
2025-11-16 Add SDC41 CO2/temperature/humidity sensor integration
    - Integrate SDC41 sensor via I2C (GPIO 38 SDA, GPIO 21 SCL)
    - Read sensor values every minute (same timing as clock update)
    - Add sensor initialization and error handling
    - Separate sensor reading from display update to prevent crashes
    - Add README_SDC41.md documentation
    - Revert status line to original format (bottom, single line, font 16)
    [EPDClock.ino]
2025-11-16 Move status line to top of screen
    - Move drawStatus() to display at top instead of bottom
    - Remove EPD_ClearWindows() call to prevent memory access crash
    - Status line now displays without clearing area (overwrites previous content)
    - Keep font size 16 and single line format
    [EPDClock.ino]
2025-11-16 Refactor: Split main file into separate modules
    - Split EPDClock.ino into display_manager, network_manager, sensor_manager, and imagebw_export modules
    - Consolidate clock update logic to remove duplication
    - Fix ImageBW export to only run when clock updates (every minute)
    - Enable sensor reading when clock updates
    - Add WiFi status check before periodic ImageBW export attempts
    [EPDClock.ino, display_manager.cpp, display_manager.h, imagebw_export.cpp, network_manager.cpp, network_manager.h, sensor_manager.cpp]
2025-11-16 Add sensor display with icons and units
    - Add Number M font (58px height) for sensor values
    - Add temperature, humidity, and CO2 display with icons
    - Add unit icons (C, %, ppm) displayed below values
    - Add sensor manager functions to get humidity and CO2
    - Improve display update flow: read sensor when minute changes
    - Rename DisplayManager_UpdateClock to DisplayManager_UpdateDisplay
    - Add icon and unit bitmap assets
2025-11-16 Refactor sensor data layout and icon bitmap management
    - Rewrite sensor data layout logic with dynamic positioning
    - Calculate display width for each sensor data (icon + value + unit)
    - Position temp at x=16, CO2 at right edge, humidity centered
    - Use 6px spacing between icon and value, 5px between value and unit
    - Add width calculation functions
    - calculateTemperatureWidth() for temperature values
    - calculateIntegerWidth() for integer values
    - Refactor icon bitmap management
    - Create convert_icon.py script to convert PNG to header files
    - Split icons and units into individual header files
    - Update Icon_bitmap.h to include individual headers
    - Support both icon_* and unit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
2025-11-16 Remove temperature offset code and use low power measurement mode
    - Remove all temperature offset related code (getTemperatureOffset, setTemperatureOffset)
    - Change from startPeriodicMeasurement() to startLowPowerPeriodicMeasurement()
    - Low power mode reduces self-heating and improves temperature accuracy
    - Update documentation to reflect changes
2025-11-16 Add temperature offset read on startup
    - Read current temperature offset value on startup
    - Comment out offset setting code (read only)
    - Use low power periodic measurement mode to reduce self-heating
    - Remove persistSettings() call (settings not persisted to EEPROM)
2025-11-19 Fix EPD_ClearWindows crash and improve status display
    - Fix EPD_DrawLine: correct dy calculation and add special case handling for horizontal/vertical lines
    - Fix EPD_DrawRectangle: clamp coordinates to prevent out-of-bounds access
    - Fix EPD_ShowChar: add range check for character codes to prevent font array overflow
    - Fix EPD_ShowString: add null pointer check
    - Fix Paint_SetPixel: add comprehensive range checks including offset handling
    - Improve status display: show detailed WiFi, IP, RSSI, NTP, uptime, heap, and status message
    - Move setup status display to top status area with same format
    - Add DisplayManager_SetStatus function for centralized status message management
    - Remove String c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
    [EPD.cpp, EPDClock.ino, display_manager.cpp, display_manager.h]
2025-11-19 Fix status message display: clear after sensor read and hide Msg label when empty
    [display_manager.cpp]
2025-11-22 Update display layout: reposition clock, date, and sensor values
2025-11-22 Replace 12px font with Spleen 6x12 monospaced bitmap font
    - Include EPDfont_12px_spleen.h for new 12px font
    - Comment out original ascii_1206 font definition
    - Update EPD.cpp to use ascii_1206_spleen for size1==12
    - Format other font arrays (ascii_1608, ascii_2412, ascii_4824) for consistency
    [EPD.cpp, EPDfont.h, EPDfont_12px_spleen.h]
2025-11-22 Implement EPD deep sleep functionality
    - Add EPD_DeepSleep() call after display update to reduce power consumption
    - Wake up EPD from deep sleep only when display update is needed (minute change)
    - Use EPD_FastMode1Init() and restore display buffer on wakeup
    - Include EPD_Init.h in both EPDClock.ino and display_manager.cpp
2025-11-22 Implement ESP32 deep sleep and optimizations
    - Add DeepSleepManager for handling RTC memory and sleep logic
    - Store frame buffer in SPIFFS with RLE compression to persist screen across sleep
    - Restore screen RAM on wake-up to enable partial updates without full refresh
    - Save and restore system time in RTC memory to maintain clock accuracy without WiFi
    - Optimize WiFi/NTP sync frequency (once per hour) to save power
    - Fix double initialization of SDC41 sensor
    - Update DisplayManager to handle wake-from-sleep initialization
    [EPDClock.ino, deep_sleep_manager.cpp, deep_sleep_manager.h, display_manager.cpp, display_manager.h, sensor_manager.cpp]
2025-11-22 Fix SCD41 initialization logic and improve I2C stability during deep sleep
    - Update to handle wake-from-sleep logic correctly:
    - Always perform full initialization on cold boot.
    - Attempt to skip initialization and resume periodic mode on wake-from-sleep.
    - Add and to prevent I2C bus glitches during deep sleep/wake cycles, which caused sensor reset.
    - Improve I2C robustness with retries and timeout adjustments.
    - Update log messages for clarity.
    [EPDClock.ino, deep_sleep_manager.cpp, deep_sleep_manager.h, sensor_manager.cpp, sensor_manager.h]
2025-11-22 Set SCD41 temperature offset to 4.0C and clean up I2C debugging code
    - Set temperature offset to 4.0C to compensate for self-heating/board heat.
    - Remove debug getTemperatureOffset calls from wake-up path to prevent I2C bus conflicts and errors during periodic measurements.
    - Ensure robust sensor initialization and data reading flow.
    [sensor_manager.cpp]
2025-11-22 Implement SD card support for frame buffer storage
    - Add SD card (TF card) support using HSPI bus (pins: MOSI=40, MISO=13, SCK=39, CS=10)
    - Automatically fallback to SPIFFS if SD card is not available
    - Fix compression buffer size issue (allocate 2x size for RLE worst case)
    - Add warning messages for SPIFFS fallback mode
    - Update REVIEW_ISSUES.md with ESP32-S3 flash memory write endurance details
    - SD card provides much better write endurance (1M+ cycles) compared to SPIFFS (10K-100K cycles)
    [deep_sleep_manager.cpp, deep_sleep_manager.h]
2025-11-22 Optimize sensor read timeout and add timing logs
    - Reduce blocking timeout from 40s to 2s (wake from sleep) / 5s (cold boot)
    - Add detailed timing logs to measure actual sensor read duration
    - Add fallback to non-blocking read on timeout
    - Update REVIEW_ISSUES.md: Mark issue 1.2 as resolved (actual read time is only ~4-15ms)
    [EPDClock.ino, sensor_manager.cpp]
2025-11-22 Remove RLE compression for frame buffer storage
    - Remove compressRLE and decompressRLE functions
    - Remove compressionBuffer variable
    - Save/load frame buffer directly without compression
    - Rename compressedImageSize to imageSize in RTCState
    - Update documentation to mark issue 1.3 as resolved
    With TF card support, compression is no longer needed. This simplifies
    the code, reduces memory usage, and eliminates compression failures.
    [deep_sleep_manager.cpp, deep_sleep_manager.h]
2025-11-22 Fix issues from REVIEW_ISSUES.md
    - Fix temperature display for negative values (clamp to 0)
    - Improve SPIFFS error handling (skip save/load on mount failure)
    - Improve time restoration accuracy using ESP32 RTC timer
    - Remove incorrect timeout checks in SensorManager_Read()
    - Replace magic number with kNtpSyncIntervalBoots constant
    - Unify error message format (use FAILED consistently)
    - Remove unused lastNtpSync variable from NetworkState
    - Update outdated comments in sensor_manager.cpp
    - Increase statusLine buffer size from 128 to 256 bytes
    [EPDClock.ino, deep_sleep_manager.cpp, deep_sleep_manager.h, display_manager.cpp, network_manager.cpp, network_manager.h, sensor_manager.cpp]
2025-11-22 Add logging framework with timestamp, level, tag, and message support
    - Add logger.h and logger.cpp with LogLevel (DEBUG, INFO, WARN, ERROR) and TimestampMode support
    - Replace all Serial.print/println calls with logger macros (LOGI, LOGW, LOGE, LOGD)
    - Add LogTag namespace with constants for all tags (SETUP, LOOP, NETWORK, SENSOR, DISPLAY_MGR, DEEPSLEEP, IMAGEBW)
    - Timestamp format: milliseconds from boot (e.g., [1234ms])
    - Support for NTP-synced date/time timestamps (when available)
    - Color-coded log levels for better readability in terminal
    [EPDClock.ino, deep_sleep_manager.cpp, display_manager.cpp, imagebw_export.cpp, logger.cpp, logger.h, network_manager.cpp, sensor_manager.cpp]
2025-11-23 Optimize SCD41 sensor for idle single-shot mode
    - Switch to idle single-shot mode (more efficient for 1-minute intervals)
    - Remove powerDown() call before deep sleep (sensor stays in idle state)
    - Idle single-shot: ~1.5mA vs power-cycled: ~2.6mA for 1-minute intervals
    - Enables ASC (Automatic Self-Calibration)
    - Fix sensor reading in display_manager.cpp
    - Replace SensorManager_Read() with SensorManager_ReadBlocking()
    - SensorManager_Read() only works with periodic mode, not single-shot
    - Update timeout settings
    - Use 6 second timeout for single-shot measurements (measureSingleShot takes ~5s)
    - Remove invalid fallback to SensorManager_Read()
    - Code cleanup and optimization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
    [EPDClock.ino, display_manager.cpp, sensor_manager.cpp, sensor_manager.h]
2025-11-23 Fix sensor name: SDC41 -> SCD41
    - Correct sensor name from SDC41 to SCD41 (Sensirion CO2 Detector 41)
    - Update all code comments and log messages
    - Rename README_SDC41.md to README_SCD41.md
    - Update documentation references
    [EPDClock.ino, deep_sleep_manager.cpp, sensor_manager.cpp]
2025-11-23 Implement GPIO wakeup (HOME key) with full screen refresh and optimize sensor read timing
2025-11-23 Remove blocking sensor read during display update
    This prevents a 5-second blockage during EPD update which likely caused noise issues. Sensor data is already read in setup(), so this call was redundant.
    [display_manager.cpp]
2025-11-23 Remove blocking sensor read during full display update
    Apply the same fix to DisplayManager_FullUpdate to prevent 5-second blocking during button-triggered updates.
    [display_manager.cpp]
2025-11-23 Restore blocking sensor read in setup()
    Since we removed the sensor read from DisplayManager to fix EPD noise, we must read the sensor in setup() BEFORE the display update starts. This ensures we have valid data to display without causing noise issues.
    [EPDClock.ino]
2025-11-23 Fix SPIFFS write error with auto-format recovery and disable ImageBW export
    [deep_sleep_manager.cpp, sensor_manager.cpp, server_config.h]
2025-11-24 Update SCD41 I2C SCL pin to GPIO 20 and refactor pin constants
2025-11-24 fix: Hold EPD control pins during deep sleep to prevent noise
    [EPDClock.ino, deep_sleep_manager.cpp, deep_sleep_manager.h]
2025-11-24 Add WiFi failure recovery and refactor display update logic
    - Add NetworkManager_SetupTimeFromRTC() to restore time from RTC when WiFi/NTP fails
    - Update DisplayManager_UpdateDisplay to show sensor values even when time is unavailable
    - Display 'No Time' and 'WiFi Failed' messages when time cannot be retrieved
    - Refactor DisplayManager_UpdateDisplay and DisplayManager_FullUpdate to use common performUpdate() function
    - Always show 'Starting...' status message before final display update
    [EPDClock.ino, display_manager.cpp, network_manager.cpp, network_manager.h]
2025-11-24 Add battery voltage measurement with ADC calibration
    - Add battery voltage measurement using GPIO8 ADC pin
    - Implement linear calibration equation (Vbat = 0.002334 * adc_raw - 1.353) to compensate for ESP32-S3 ADC non-linearity
    - Read ADC 10 times and calculate average to reduce noise
    - Display battery voltage in status bar (top left) with format B:3.845V
    - Update battery voltage every minute along with display update
    [Icon_co2_bitmap.h, Icon_humidity_bitmap.h, Icon_temp_bitmap.h, display_manager.cpp]
2025-11-24 Optimize ADC reading for 470kΩ voltage divider
    - Add dummy read before sampling to stabilize ADC
    - Read 16 times with 50µs delay between readings
    - Follow recommended practice for high-impedance voltage divider
    [display_manager.cpp]
2025-11-24 Move battery voltage measurement to early setup phase
    - Move battery voltage measurement before WiFi/sensor operations
    - Measure voltage when battery is in near-idle state (no load) for more accurate reading
    - Add DisplayManager_ReadBatteryVoltage() function for early measurement
    - Store measured voltage in global variable g_batteryVoltage
    - Remove delay(1000) from setup() as it's not needed
    - Move battery voltage constants and global variable outside namespace for proper linking
2025-11-25 Use float accumulation for glyph positioning precision
    - Add float versions of advance/kerning functions:
    - getAdvanceLf(), getAdvanceMf(), getAdvancef()
    - getKerningLf(), getKerningMf(), getKerningf()
    - Update drawGlyphSequence() to accumulate in float
    - Only round to integer when actually drawing
    - Prevents cumulative rounding errors in long text
    - Update calcGlyphSequenceWidth() to use float accumulation
    - Remove unused FONT_SIZE_S constant
    - Keep integer versions for backward compatibility
    [Kerning_table.h]
2025-11-25 Fix SD card initialization by enabling power pin (GPIO 42)
    [deep_sleep_manager.cpp]
2025-11-25 Power off SD card during deep sleep to save battery
2025-11-25 Rename project from EPDClock to EPDEnvClock
    - Rename Arduino sketch directory from EPDClock/ to EPDEnvClock/
    - Rename main sketch file from EPDClock.ino to EPDEnvClock.ino
    - Update all references in documentation (README.md, AGENTS.md, docs/)
    - Update Python scripts to use new directory paths
    - Update code comments to reference new project name
2025-11-25 Update README.md to reflect current codebase
    - Fix SCL pin number (GPIO 21 -> GPIO 20)
    - Fix date format description (YYYY/MM/DD -> YYYY.MM.DD)
    - Fix layout Y positions (date y=55->45, time y=133->123)
    - Add battery voltage monitoring feature
    - Add HOME button deep sleep wakeup feature
    - Add light sleep optimization during sensor measurement
    - Add font renderer with kerning support
    - Add logger system description
    - Add SD card power control for deep sleep
    - Update power consumption details with table
    - Add troubleshooting for time and SD card issues
    - Update technical specifications with I2C pins and measurement mode
2025-11-25 Rewrite AGENTS.md for AI agents in English
    - Simplified to essential points only
    - Added critical hardware pin details
    - Added code architecture overview
    - Listed key implementation details (power, display, time, sensor)
    - Added common pitfalls section
    - Removed verbose human-oriented documentation
2025-11-25 Add sensor logging to SD card with RTC drift measurement
    - Add JSONL sensor logging to SD card (sensor_logger.cpp/h)
    - Logs date, time, unix timestamp, temp, humidity, CO2, battery ADC/voltage
    - Creates daily log files: /sensor_logs/sensor_log_YYYYMMDD.jsonl
    - Only logs to SD card (no SPIFFS fallback)
    - Add RTC drift measurement during NTP sync
    - Measures drift in milliseconds (NTP time - RTC time)
    - Logs rtc_drift_ms only when NTP synced AND drift is valid
    - Skips drift calculation on first boot (invalid RTC time)
    - Change NTP sync interval from 60 minutes to 10 minutes
    - More frequent drift measurements for RTC accuracy tracking
    - Fix EPD update order: EPD_DeepSleep() befo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
    [EPDEnvClock.ino, deep_sleep_manager.cpp, deep_sleep_manager.h, display_manager.cpp, display_manager.h, sensor_logger.cpp, sensor_logger.h, sensor_manager.cpp]
2025-11-25 Revert NTP sync to 1 hour interval, add old log file cleanup
    - Revert NTP sync interval from 10 minutes back to 60 minutes (1 hour)
    - Add automatic deletion of sensor log files older than 30 days
    - Runs during SensorLogger_Init() on every boot
    - Parses date from filename (sensor_log_YYYYMMDD.jsonl)
    - Logs deleted files for debugging
    [EPDEnvClock.ino, deep_sleep_manager.h, sensor_logger.cpp, sensor_logger.h]
2025-11-26 feat: two-phase display update - show time first, then sensor values
    - Add DisplayManager_UpdateTimeOnly() to show time/date immediately on boot
    - Add DisplayManager_UpdateSensorOnly() to add sensor values after reading
    - Improves UX: user sees clock right away instead of waiting 5s for sensor
    - Sensor reading happens during light sleep between two partial updates
2025-11-26 fix: preserve previous sensor values during time-only update
    Don't clear entire frame buffer - only clear time/date/status areas.
    Sensor values from previous frame buffer remain visible while time updates.
    [display_manager.cpp]
2025-11-26 perf: show clock before sensor init for faster display
    Move DisplayManager_UpdateTimeOnly() before sensor initialization.
    Clock now displays ~1s after boot instead of ~3s.
    Sensor init (~2s) now happens after clock is already visible.
2025-11-26 fix: increase wakeup buffer from 2s to 3s
    Boot + EPD restore + time display takes ~2.5 seconds,
    so 2 second buffer was not enough. Now using 3 second buffer.
    [deep_sleep_manager.cpp]
2025-11-26 fix: wake up AFTER minute boundary, not before
    Was waking up 3 seconds BEFORE the next minute, so clock showed old minute.
    Now wakes up 2 seconds AFTER the minute boundary.
    Example: at 23:56:05, sleep for 57 seconds (not 52), wake at 23:57:02,
    then display shows 23:57 correctly.
    [deep_sleep_manager.cpp]
2025-11-26 fix: clear sensor area before drawing new values
    Prevents old sensor values from showing through when digits change.
    [display_manager.cpp]
2025-11-26 perf: skip clearing status bar in time-only update
    Status bar doesn't change between updates, so no need to clear it.
    [display_manager.cpp]
2025-11-27 Fix status line stuck at 'Initializing Sensor...'
    - Ensure drawStatus is called after sensor update in DisplayManager_UpdateSensorOnly
    - Remove redundant drawStatus call in DisplayManager_UpdateTimeOnly to prevent flickering during startup sequence
    [display_manager.cpp]
2025-11-27 Add web dashboard for sensor data visualization
    - Astro + Cloudflare Pages + D1 setup
    - TypeScript with Chart.js for charts
    - API endpoints: POST /api/sensor, GET /api/data
    - Dashboard displays temperature, humidity, CO2, battery
    - Responsive design for mobile
    - Time range selector (6H/12H/24H/3D/7D)
    - Dummy data seed script for development
2025-11-27 Add API key authentication for sensor endpoint
    - POST /api/sensor now requires X-API-Key header
    - Uses .dev.vars for local development (Cloudflare adapter)
    - Falls back to no auth if API_KEY not configured (dev mode)
    - Updated send-dummy-data.ts script with --api-key option
    - Added .dev.vars.example template
2025-11-28 Add batch sensor data upload to Cloudflare Pages API
    - Add SensorLogger_GetUnsentReadings() to retrieve unsent data from SD card
    - Add NetworkManager_SendBatchData() to POST sensor data to server
    - Track last uploaded timestamp in RTC memory (lastUploadedTime)
    - Separate secrets (API URL, API key) into secrets.h (gitignored)
    - Rename server config variables: SERVER_IP -> IMAGEBW_SERVER_IP, etc.
    - Update server API to accept both 'timestamp' and 'unixtimestamp' fields
    - Add validation for required fields in server API
    - Add debug logging for batch upload payload
2025-11-28 Add UNIQUE constraint on timestamp to prevent duplicate records
    - Use INSERT OR IGNORE to silently skip duplicates
    - Add UNIQUE constraint to timestamp column in schema
2025-11-28 Update README with ESP32 sensor upload documentation
    - Add ESP32 setup section (secrets.h configuration)
    - Document how batch upload works (60-min interval, SD card logs)
    - Add field notes for API (unixtimestamp, optional fields)
    - Document duplicate handling (INSERT OR IGNORE)
2025-11-28 Switch from npm to bun for web project
2025-11-28 docs: Update README to English, add Japanese version, consolidate AGENTS.md info
    - Translate README.md to English as primary documentation
    - Add README_ja.md as Japanese version with language links
    - Add complete pin configuration tables (SD Card, EPD, Buttons, Battery ADC)
    - Add Web Dashboard section with deployment instructions
    - Add Common Pitfalls section
    - Remove AGENTS.md links, integrate required info into README
    - Standardize Wi-Fi spelling across all documentation
2025-11-28 Add Cloudflare Access auth and improve NTP sync timing
    - Add CF-Access-Client-Id/Secret headers for Cloudflare Access protected API
    - ESP32: Add CF-Access headers to NetworkManager_SendBatchData
    - Python: Add CF-Access support with .env file loading
    - Change NTP sync to run at top of every hour (xx:00) instead of boot count
    - Improve first boot upload: get recent 60 readings, set lastUploadedTime to now
    - Remove unused kNtpSyncIntervalBoots and ShouldResyncNtp function
    - Add .env to .gitignore for secure credential storage
2025-11-28 Add min/max stats to dashboard
    - Update /api/data to calculate and return min/max for temp, humidity, CO2, battery
    - Add min/max display below current values in stat cards (↓min ↑max format)
    - Add responsive styles for mobile
2025-11-29 Fix sensor logger to send latest 60 readings instead of oldest
    The previous implementation read log files from the beginning and stopped
    after 60 entries, which caused it to always send the oldest unsent data.
    When a backlog accumulated (e.g., from a missed upload), newer data kept
    getting delayed while old data was prioritized.
    Changed to use a circular buffer that keeps only the latest maxReadings
    entries. This ensures recent data is always sent first, and old backlog
    is discarded.
    [sensor_logger.cpp]
2025-11-29 Add MAX17048 fuel gauge support
    - Add fuel_gauge_manager module for MAX17048 on separate I2C bus (Wire1, SDA=14, SCL=16)
    - Replace ADC-based battery reading with fuel gauge (with ADC fallback)
    - Display battery percentage and voltage in status line (e.g., '100%(4.18V)')
    - Log battery voltage, percentage, and charge rate to JSONL
    - Quick Start on init to ensure accurate SOC readings
    [EPDEnvClock.ino, display_manager.cpp, display_manager.h, fuel_gauge_manager.cpp, fuel_gauge_manager.h, sensor_logger.cpp, sensor_logger.h]
2025-11-29 Update dashboard to show battery percentage
    - Add battery_percent and battery_rate columns to schema
    - Update sensor API to accept and store new battery fields
    - Update data API to return battery_percent
    - Change dashboard to display battery % instead of voltage
    - Show voltage as secondary info below percentage
    - Update battery chart to show percentage (0-100%)
2025-11-29 Improve battery display in dashboard
    - Show voltage next to percentage with smaller font
    - Combined min/max display: 'min 80 (3.75) max 100 (4.20)'
    - Add voltage line (light green) to battery chart with dual y-axes
    - Update dummy data scripts to include battery_percent and battery_rate
2025-11-29 Update documentation for MAX17048 fuel gauge
    - Add MAX17048 I2C pins (Wire1: SDA=14, SCL=16)
    - Add fuel_gauge_manager to code architecture
    - Update battery monitoring section (remove ADC fallback)
    - Add Adafruit MAX1704X to required libraries
    - Update pin configuration tables
    - Add MAX17048 to external components
    - Update data logging fields (battery %, charge rate)
    - Add MAX17048 current consumption (~3µA hibernate)
    - Add common pitfall: battery must be connected
2025-11-29 Overhaul documentation and add MIT license
    README.md changes:
    - Remove ImageBW from main features (debug feature)
    - Remove internal font names (Number L/M)
    - Fix NTP sync: runs at top of every hour, not every 60 boots
    - Wi-Fi config requires recompile for new SSID/password
    - Remove SPIFFS fallback mention for logging (no fallback)
    - External components are required, not optional
    - Simplify USB driver docs: link to SparkFun for all OS
    - macOS built-in driver only works for console, official driver needed for upload
    - Keep only macOS for arduino-cli installation
    - Update Sensirion Core version to 0.7.2
    - Fix ImageBW server config variable names
    - Add MAX17048 fuel gauge to Technical Specificat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
2025-11-29 Fix documentation accuracy after code review
    - Add sensor_logger.* and secrets.h to project structure
    - Update scripts list (add convert_icon.py, upload_sensor_data.py)
    - Fix buffer size description: 27,200 bytes (800×272÷8)
    - Fix EPD pins: CS=45, DC=46, RST=47, BUSY=48 (not CS_M/CS_S)
    - Fix dual controller offset: 8px (not 4px gap)
    - Fix status display: shows battery % and voltage
    - Remove ImageBW debug scripts from general list
2025-11-29 Update Japanese README with same changes as English version
    - Add MAX17048 fuel gauge documentation
    - Fix NTP sync timing (top of every hour)
    - Remove SPIFFS fallback mention for logging
    - Simplify USB driver docs (link to SparkFun)
    - Update library versions (Sensirion Core 0.7.2, add MAX1704X)
    - Update project structure (add fuel_gauge_manager, sensor_logger, secrets.h)
    - Fix EPD pins (CS=45, DC=46, RST=47, BUSY=48)
    - Fix buffer size and dual controller offset (8px)
    - Remove Number S references
    - Re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
2025-11-29 Update remaining documentation files
    docs/README_SCD41.md:
    - Fix temperature offset: 4.0°C (not -3.0°C)
    - Simplify temperature offset explanation
    docs/README_IMAGEBW.md:
    - Fix server config variable names (IMAGEBW_SERVER_IP/PORT)
    - Add ENABLE_IMAGEBW_EXPORT to example
    web/README.md:
    - Fix NTP sync timing (top of every hour, not every 60 boots)
    - Update log format with batt_percent and batt_rate
    - Update API request examples with new battery fields
2025-11-29 Update ESP32 Core version to 2.0.12
    - Upgrade from 2.0.7 to 2.0.12 (latest v2.x)
    - Add note explaining why v3.x is not compatible (Adafruit library issues)
    - 2.0.12 includes ESP32-S3 GPIO 48 interrupt fix (used for BUSY pin)
    - Binary size reduced by ~54KB
    [EPDEnvClock.ino, deep_sleep_manager.cpp, sensor_logger.cpp]
2025-11-30 Add charging state detection from 4054A CHRG pin
    - Add Charging_Init() and Charging_IsCharging() to fuel_gauge_manager
    - Read CHRG pin (GPIO 8) before I2C operations to avoid noise
    - Add g_batteryCharging global variable
    - Show [CHG] indicator in status bar when charging
    - Log charging state to sensor log file
    [EPDEnvClock.ino, display_manager.cpp, display_manager.h, fuel_gauge_manager.cpp, fuel_gauge_manager.h, sensor_logger.cpp, sensor_logger.h]
2025-11-30 Add charging state support to web dashboard
    - Add battery_charging column to schema
    - Update sensor API to receive and store charging state
    - Update data API to return charging state
    - Add charging overlay (red area) to battery chart
    - Update dummy data with simulated charging sessions
2025-11-30 Update documentation for charging state detection
    - Add 4054A CHRG pin (GPIO 8) to hardware documentation
    - Update fuel_gauge_manager description to include charging detection
    - Add charging state to data logging recorded fields
    - Document open-drain behavior and I2C noise avoidance strategy
2025-12-01 Align chart x-axis labels to hour boundaries
    - Add chartjs-adapter-date-fns for time scale support
    - Change x-axis from category to time type
    - Configure unit/stepSize for clean hour-aligned tick labels
    - Data points remain at their actual timestamps
2025-12-01 Add device, wiring diagram, and dashboard images to README
2025-12-01 Change voltage chart range to 3.0-4.2V on dashboard
2025-12-03 Improve upload resilience: retry 3x and keep 2 hours of data
    - Add retry logic (3 attempts with 1 second delay) for batch data upload
    - Increase maxReadings from 60 to 120 (2 hours worth of data)
    - This prevents data loss when a single upload attempt fails
    - If upload fails at one hour mark, data is preserved for next sync
    [EPDEnvClock.ino, sensor_logger.cpp, sensor_logger.h]
2025-12-03 Add missing battery fields to upload script
    - Add batt_percent, batt_rate, charging fields to match current log format
    [upload_sensor_data.py]
2025-12-03 Add persistent ERROR/WARN logging to SD card
    - Buffer ERROR and WARN level logs in memory (up to 32 entries)
    - Flush buffered logs to SD card before entering deep sleep
    - Log file: /error_logs/error_YYYYMMDD.log
    - Helps diagnose issues like upload failures without serial monitor
    [EPDEnvClock.ino, logger.cpp, logger.h]
2025-12-08 Fix chart X-axis to always show full selected time range
    Previously, charts would auto-scale to fit only the data range,
    which was confusing when data was missing. Now the X-axis always
    spans the full selected period (6H, 12H, 24H, etc.) regardless of
    whether data exists for the entire range.
2025-12-08 Improve chart X-axis labels for 3D and 7D views
    - 3D/7D: Show date with day of week (MM/dd (EEE)) instead of hourly
    - 3D: Use daily step instead of 6-hour step
    - Short ranges (6H/12H/24H): Keep hourly format (HH:mm)
2025-12-08 Setup project-specific Arduino environment for ESP32 2.0.17
    - Add arduino-cli.yaml for project-specific ESP32 2.0.17 installation
    - Update .gitignore to exclude .arduino15/ but include arduino-cli.yaml
    - Update VSCode IntelliSense config to use project-specific paths
    - Update AGENTS.md, README.md, README_ja.md with new build instructions
    - This allows using ESP32 2.0.17 without conflicting with other projects using 3.x
2025-12-08 Fix RTC drift measurement to exclude WiFi connection time
    Move RTC time capture to immediately before NTP sync instead of before
    WiFi connection. This ensures drift measurement only includes actual
    RTC crystal drift, not WiFi connection latency.
    Previously, drift values showed two groups:
    - ~5300ms: Normal RTC drift when WiFi connected quickly
    - 25k-30k ms: Included WiFi connection time (20+ seconds)
    Now drift measurement accurately reflects only RTC drift (~5.3s/hour).
    [EPDEnvClock.ino, network_manager.cpp]
2025-12-10 Add battery discharge analysis report (Dec 1-10, 2025)
    - Add BATTERY_REPORT.md with 10-day discharge analysis
    - Add interactive battery_chart.html with Chart.js visualization
    - Add battery_chart.png screenshot for markdown embedding
    - Update docs README files to link to the battery report
    - Ignore logs/ directory (device SD card data)
2025-12-10 Implement linear battery percent for display and logging
    - Add FuelGauge_GetLinearPercent() with 3.4V=0%, 4.2V=100%
    Based on actual discharge testing: device crashes at ~3.4V with WiFi
    - Display shows linear percent (more accurate below 3.8V)
    - Keep MAX17048 percent as reference in g_batteryMax17048Percent
    - Log both values: batt_percent (linear) and batt_max17048_percent
    - Update log format to include both percentages for analysis
    [EPDEnvClock.ino, display_manager.cpp, display_manager.h, fuel_gauge_manager.cpp, fuel_gauge_manager.h, sensor_logger.cpp, sensor_logger.h]
2025-12-10 Add battery_max17048_percent to dashboard and update docs
    - Add battery_max17048_percent column to D1 database schema
    - Update sensor.ts API to accept and store MAX17048 percent
    - Update AGENTS.md with battery percentage calculation details
    - Update web/README.md with new field documentation
    - Run DB migration: ALTER TABLE sensor_data ADD COLUMN battery_max17048_percent
2025-12-10 Skip WiFi/NTP sync on low battery
    [EPDEnvClock.ino]
2025-12-10 Persist lastUploadedTime to SD card across power cycles
    Store upload timestamp to /last_uploaded.txt so unsent sensor logs
    can be uploaded after power loss or brownout recovery.
    [EPDEnvClock.ino, deep_sleep_manager.cpp, deep_sleep_manager.h]
2025-12-13 Remove ADC fallback and add battery voltage validation
    - Remove ADC battery fallback (no ADC battery port connected)
    - Add voltage validation: 2.0V-4.4V range, return -1.0f for invalid
    - Display shows 'ERR' when battery reading is invalid
    - Sensor log outputs null for invalid battery values
    - Skip WiFi when battery sensor returns error
    - FuelGauge_GetVoltage now logs warning for out-of-range values
    This fixes garbage values (5.1V, -1.3V) from ADC fallback and
    MAX17048 malfunction at low voltage.
    [EPDEnvClock.ino, display_manager.cpp, display_manager.h, fuel_gauge_manager.cpp, fuel_gauge_manager.h, sensor_logger.cpp]
2025-12-13 Update battery report with 12/12-12/13 analysis
    - Add 12/12 and 12/13 data to daily breakdown
    - Add detailed low-voltage discharge analysis (3.42V → 3.09V)
    - Document MAX17048 I2C failure event
    - Update conclusions with new findings
    - Mark implemented recommendations (linear %, voltage validation, etc.)
    [EPDEnvClock.ino, fuel_gauge_manager.cpp, sensor_logger.cpp]
2025-12-13 Fix RTC drift measurement to exclude NTP sync wait time
    - Add SaveNtpSyncDuration() to record NTP sync wait time
    - Subtract sync wait time from drift calculation in MarkNtpSynced()
    - This ensures only actual RTC crystal drift is measured, not NTP sync latency
    - Add analyze_data.py script for analyzing sensor data from D1 database
    - Update AGENTS.md with data analysis script documentation
    [analyze_data.py, deep_sleep_manager.cpp, deep_sleep_manager.h, network_manager.cpp]
2025-12-13 Allow WiFi connection when charging even if battery voltage is low
2025-12-13 Add datetime to SD error logs using RTC time
    Previously, SD error logs only showed boot time (millis) because they
    checked ntpSynced flag. Now uses getLocalTime() directly, which works
    with RTC-restored time after deep sleep. Includes both datetime and
    boot time for easier correlation.
    [logger.cpp]
2025-12-13 Fix misleading log message about ADC fallback
    [display_manager.cpp]
2025-12-14 Use delay() instead of light_sleep() when WiFi is connected
    Light sleep disconnects WiFi, requiring reconnection for batch upload.
    Using delay() during sensor measurement when WiFi is active avoids
    this overhead and actually saves more power overall:
    - delay(5s): ~0.028mAh
    - light_sleep(5s) + WiFi reconnect(5s): ~0.140mAh
    Non-WiFi boots still use light_sleep for maximum power savings.
    [EPDEnvClock.ino, sensor_manager.cpp, sensor_manager.h]
2025-12-14 Add dual-core parallel processing for WiFi/NTP and sensor reading
    - Add parallel_tasks module using FreeRTOS tasks
    - WiFi/NTP runs on Core 0, sensor reading on Core 1
    - Reduces startup time by ~2 seconds (parallel vs sequential)
    - Screen update reduced from 2 times to 1 time
    - Remove DisplayManager_UpdateTimeOnly/UpdateSensorOnly (no longer needed)
    - Update AGENTS.md with new module documentation
    [EPDEnvClock.ino, display_manager.cpp, display_manager.h, parallel_tasks.cpp, parallel_tasks.h]
2025-12-14 Add arduwrap CLI tool for compile/upload with serial monitoring
    - Python wrapper for arduino-cli with serial port management
    - Pauses serial monitoring during upload, auto-reconnects after
    - Supports log retrieval, filtering, and buffer management
    - Update README with arduwrap usage instructions
2025-12-14 Update README docs with dual-core parallel processing details
    - Add parallel_tasks module to project structure
    - Update power management features section
    - Document dual-core parallel processing optimization
    - Update Deep Sleep cycle active time description
2025-12-22 Use light_sleep for sensor wait when WiFi sync not needed
    Power optimization: When WiFi/NTP sync is not needed (98% of cycles),
    run sensor reading in single-core mode with light_sleep instead of
    parallel processing with delay(). This saves ~1.5 mAh/hour.
    - WiFi sync needed: Use dual-core parallel processing (WiFi + Sensor)
    - WiFi sync not needed: Use single-core with light_sleep during 5s sensor wait
    Also includes:
    - Adaptive sleep duration calculation with millisecond precision
    - Battery consumption analysis scripts for local log files
2025-12-22 Fix time drift (~1 min/hour) caused by integer truncation in restoreTimeFromRTC
    Previous implementation used integer division when restoring time after
    deep sleep, causing up to ~1 second loss per wake cycle:
    - savedTime was time_t (seconds only, losing fractional part)
    - sleepDurationUs / 1000000 truncated fractional seconds
    - bootOverheadUs / 1000000 also truncated
    After 60 cycles (1 hour), this accumulated to ~60 seconds of drift.
    Fix:
    - Add savedTimeUs field to RTCState for microsecond precision
    - Save time with gettimeofday() to preserve microseconds
    - Calculate wakeup time using 64-bit microsecond arithmetic
    - Only convert to seconds at the final settimeofday() call
    Now time restora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
    [deep_sleep_manager.cpp, deep_sleep_manager.h]
2025-12-22 Add documentation for RTC and deep sleep timing system
    - docs/RTC_DEEP_SLEEP.md: Comprehensive guide covering:
    - Deep sleep cycle overview with timing diagram
    - Time restoration mechanism (microsecond precision)
    - ESP32 RTC clock sources and auto-calibration
    - Adaptive sleep duration adjustment feedback loop
    - NTP sync timing and drift measurement
    - Troubleshooting common issues
    - AGENTS.md: Add Time Restoration and Adaptive Sleep sections
    - Document microsecond precision fix (Dec 2025)
    - Explain RTC drift characteristics (~170ms/min)
2025-12-22 Add NTP drift measurement every boot (temporary diagnostic feature)
    Measure RTC drift with millisecond precision on every boot cycle
    to analyze time restoration accuracy. This is a temporary feature
    for debugging - increases battery consumption by ~50%.
    Features:
    - Custom NTP implementation with ms precision (no NTPClient library)
    - Drift-corrected adaptive processing time adjustment
    - rtc_drift_ms logged in every sensor entry
    Implementation:
    - NetworkManager_MeasureNtpDrift(): UDP-based NTP with fractional seconds
    - parallel_tasks: measureDriftOnly mode for WiFi without clock sync
    - Adaptive adjustment now uses drift-corrected actual delay
    Documentation:
    - docs/RTC_DEEP_SLEEP.md: Added d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
    [EPDEnvClock.ino, network_manager.cpp, network_manager.h, parallel_tasks.cpp, parallel_tasks.h]
2025-12-22 Replace SNTP with custom UDP NTP for faster and reliable sync
    - Replace configTime() with custom UDP NTP implementation
    - Direct UDP packet exchange instead of background SNTP service
    - NTP sync now takes ~42ms instead of 2-5 seconds
    - No more polling loop to detect SNTP completion
    - Fix hourly NTP sync detection
    - Use lastDisplayedMinute to detect minute rollover to 0
    - Handles wake-up timing variations (e.g., wake at XX:59:53)
    - Add fallback sync if last sync was >60 minutes ago
    - Add RTC calibration logging for drift analysis
    - Log RTC slow clock frequency and estimated drift at boot
    [EPDEnvClock.ino, deep_sleep_manager.cpp, network_manager.cpp, parallel_tasks.cpp]
2025-12-23 Implement RTC drift compensation with adaptive rate calibration
    - Apply drift compensation during time restoration after deep sleep
    - Track cumulative compensation to calculate true drift rate
    - Use EMA (70% old, 30% new) for stable rate convergence
    - Clamp rate to 50-300 ms/min to prevent extreme values
    - Default rate: 170 ms/min (measured on this device)
    Bug fixes:
    - Prevent double NTP sync at minute boundaries (e.g., 30 and 31)
    - Use lastDisplayedMinute to detect when entering sync minute
    Logging improvements:
    - Add cumulative_comp_ms and drift_rate to sensor logs
    - Enable temperature vs drift correlation analysis
    Debug features (temporary):
    - NTP sync at 0 and 30 minutes for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
    [EPDEnvClock.ino, deep_sleep_manager.cpp, deep_sleep_manager.h, sensor_logger.cpp, sensor_logger.h]
2025-12-23 Add drift compensation fields to D1 schema and API
    - Add cumulative_comp_ms and drift_rate columns to sensor_data table
    - Update sensor API to accept new fields
    - Update documentation (AGENTS.md, RTC_DEEP_SLEEP.md, web/README.md)
    - Deploy updated web app to Cloudflare Pages
2025-12-23 Fix cumulative_comp_ms logging to capture value before reset
    - Save cumulativeCompensationMs in ParallelTaskResults before MarkNtpSynced resets it
    - Pass the saved value to sensor logger instead of reading the already-reset value
    - This enables proper drift analysis from logged data
    [EPDEnvClock.ino, parallel_tasks.cpp, parallel_tasks.h]
2025-12-24 Document temperature dependency of RTC drift rate
    Observed Dec 2025:
    - Higher temperature → higher drift rate
    - ~22.7°C: 110-130 ms/min
    - ~21.3°C: 40-60 ms/min
    - EMA automatically adapts to temperature changes
    Updated AGENTS.md and docs/RTC_DEEP_SLEEP.md with findings.
    [parallel_tasks.cpp, parallel_tasks.h]
2025-12-24 Revert NTP sync to hourly only (remove 30-min debug sync)
    Temperature dependency observation complete. EMA drift compensation
    working correctly. No longer need frequent sync for calibration.
    [deep_sleep_manager.cpp]
2025-12-24 Persist drift rate to SD card across power cycles
    - Save calibrated driftRateMsPerMin to /drift_rate.txt on SD card
    - Restore on boot if RTC memory doesn't have calibrated value
    - Prevents EMA from restarting at default (170 ms/min) after reboot
    - Uses same pattern as lastUploadedTime persistence
    [deep_sleep_manager.cpp, deep_sleep_manager.h]
2025-12-25 Lower drift rate clamp minimum to 20 ms/min
    - Observed actual drift ~28 ms/min at 20-22°C (12/25 data)
    - Previous 50 ms/min minimum caused constant overcompensation
    - Updated default to 50 ms/min (closer to observed behavior)
    - SD card persistence means default only used on first boot
    [deep_sleep_manager.cpp, deep_sleep_manager.h]
2025-12-25 Update docs: drift rate persistence and observed values
    - Document SD card persistence for drift rate
    - Update expected values based on 12/25 observations (~28 ms/min at 20-22°C)
    - Update clamp range to 20-300 ms/min
2025-12-26 Change EMA weights to 40/60 for faster drift rate convergence
    - Previous 70/30 was too slow (9+ hours to converge)
    - New 40/60 will adapt faster to true drift rate
    - SD card persistence ensures rate survives reboots
    [deep_sleep_manager.cpp]
2025-12-26 Lower drift rate clamp minimum to 5 ms/min
    Observed true drift rate: 3-5 ms/min at 20-24°C
    Previous 20 ms/min minimum was still causing clamp
    [deep_sleep_manager.cpp]
2025-12-26 Remove drift rate clamping, only guard against NaN/extreme values
    - Let EMA handle smoothing naturally
    - Only reject NaN/inf or values outside -100 to +500 range
    - Observed true rate: 3-10 ms/min, no need for tight clamp
    [deep_sleep_manager.cpp]
2025-12-26 Fix drift rate instability: add clamp -10 to +100, EMA 50/50
    - Feedback loop was causing runaway negative drift rate
    - Clamp to -10..100 ms/min prevents extreme values
    - EMA 50/50 for balanced convergence (was 40/60)
    [deep_sleep_manager.cpp]
2025-12-27 Persist processing time and harden drift calibration
    [EPDEnvClock.ino, deep_sleep_manager.cpp, deep_sleep_manager.h]
2025-12-27 Add NTP server fallback and detailed logging
    - Add fallback NTP servers: ntp.nict.jp -> jp.pool.ntp.org -> time.google.com
    - Add detailed logging for NTP sync process (DNS resolution, packet send/receive)
    - Apply fallback mechanism to both SyncNtp and MeasureNtpDrift functions
    - Helps diagnose NTP connection issues (e.g., during NICT maintenance 12/27-29)
    [network_manager.cpp]
2025-12-27 Skip invalid drift logs after reboot
    [deep_sleep_manager.cpp, parallel_tasks.cpp]
2025-12-31 Expand drift_rate clamp range to ±600ms/min and improve EPD refresh timing
    - Expand drift_rate clamp from ±300ms/min to ±600ms/min to allow better convergence
    - Improve EPD refresh timing alignment with minute boundary (kEpdLeadTimeSec)
    - Add EPD refresh timing logs (startOffset/endOffset/wall) for monitoring
    - Fix logger timestamp to use gettimeofday() for accurate millisecond precision
    - Add persistent file logging to arduwrap with rotation and --from-file/--list-files options
    - Update documentation for drift_rate clamp range
    [EPDEnvClock.ino, analyze_data.py, arduwrap.py, deep_sleep_manager.cpp, deep_sleep_manager.h, display_manager.cpp, display_manager.h, logger.cpp]
2025-12-31 Update RTC drift correction docs for ±600ms/min clamp and alpha logic
2026-01-22 Add date range selector with preset buttons and custom date picker
    - Add 14D and 30D preset buttons to time selector
    - Add custom date range picker with start/end date inputs
    - Update fetchData to support from/to timestamp parameters
    - Extend getTimeScaleConfig for longer time periods (14D, 30D, weeks)
    - Add CSS styles for date picker components
2026-01-27 Add battery consumption rate chart to dashboard (#1)
    * Add battery consumption rate chart to dashboard
    Show battery charge/discharge rate (%/hour) from MAX17048 fuel gauge
    as a new line chart. Color-coded green for charging, red for discharging.
    Includes tooltip showing rate direction and formatted axis labels.
    https://claude.ai/code/session_0186wnNRAHWAhp4qbWUpj29v
    * Add package-lock.json for web dependencies
    https://claude.ai/code/session_0186wnNRAHWAhp4qbWUpj29v
    * Compute battery consumption rate from percent diff
    - Replace unreliable MAX17048 chargeRate() with client-side
    calculation using sliding window over battery_percent data
    - Use 15-minute window for smoothing, skip points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
2026-01-31 Improve battery consumption rate chart accuracy
    - Increase rate calculation window from 15min to 3hr to reduce noise
    - Add 10-point moving average smoothing for stable readings
    - Adjust Y-axis range from ±10 to ±2 for better visibility
2026-02-25 Fix MAX17048 intermittent failure and WiFi skip on sensor error
    - Hold Wire1 I2C pins (GPIO 14/16) HIGH during deep sleep to prevent
    bus stuck condition that made MAX17048 unreachable on wake
    - Stop skipping WiFi on battery sensor error (-1.0V); only skip on
    genuinely low battery voltage
    - Update arduino-cli.yaml and AGENTS.md paths after repo relocation
    [EPDEnvClock.ino, deep_sleep_manager.cpp]
2026-02-25 Harden battery sensor error handling and update docs
    - Add retry logic (3 attempts) to FuelGauge_Init with Wire1 bus reset
    - Check Wire1.begin() return value, tear down on failure
    - Check gpio_hold_en/gpio_hold_dis return values with error logging
    - Unify error return values to -1.0f (GetPercent, GetChargeRate)
    - Initialize battery globals to -1.0f (unknown state, not 0.0f)
    - Add warning log when WiFi proceeds despite sensor error
    - Fix display_manager.h comment: 3.0V → 3.4V for linear percent
    - Update AGENTS.md and BATTERY_REPORT.md with new behavior
    [EPDEnvClock.ino, deep_sleep_manager.cpp, display_manager.cpp, display_manager.h, fuel_gauge_manager.cpp, fuel_gauge_manager.h]
2026-03-15 Add I2C bus recovery for MAX17048 and update docs
    - Add recoverI2CBus() that bit-bangs SCL up to 9 times to release a
    stuck SDA line, then sends STOP condition to reset bus state
    - Call recoverI2CBus() on retry attempts 2+ in FuelGauge_Init() to
    automatically recover from 36-hour hang that previously required
    power cycle (MAX17048 SDA stuck LOW across deep sleep, 2026-03-13)
    - Update AGENTS.md compile command with UploadSpeed=460800 (921600
    is unstable on macOS Tahoe/Darwin 25)
    - Add arduwrap serve example with required --port and --baud flags
    - Document I2C bus recovery in Battery Monitoring section
    - Add 3 new Common Pitfalls: upload speed, I2C stuck, logs directory
    Co-Authored-By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
    [fuel_gauge_manager.cpp]
